CabrilloRoboticsClub/robosub_electrical/README.md

### Electrical stack up for RoboSub 2025 Lasershark

For documention take a look at:
https://github.com/CabrilloRoboticsClub/robosub_electrical/wiki

Desing requirments document:
https://docs.google.com/document/d/1Yq5ZJsRXAqFWiCNv81dD8MaTSv5xLRyw4zoX7664jJk/edit?usp=sharing
