CabrilloRoboticsClub/robosub_electrical/spice/Screenshot 2024-10-26 230412.png

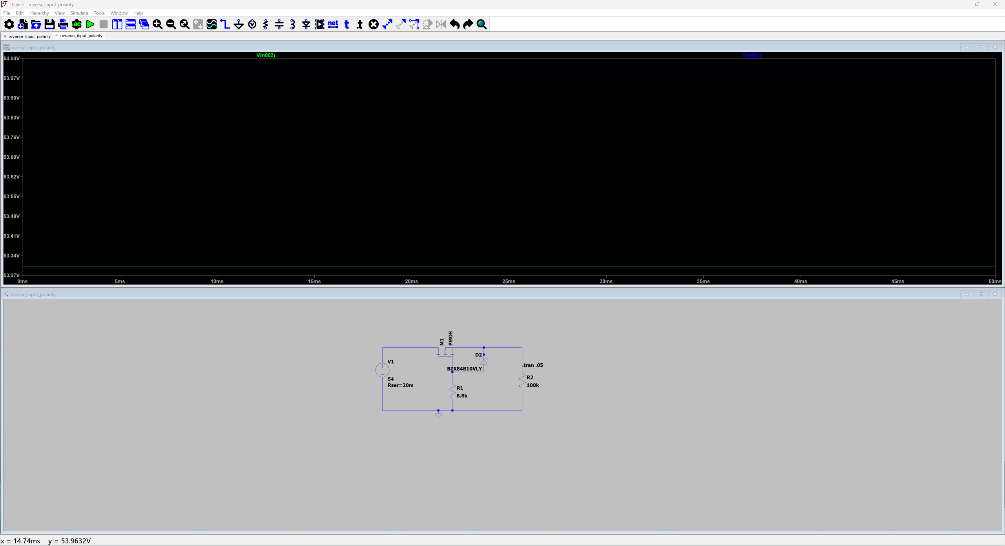
spice/Screenshot 2024-10-26 230412.png
