CabrilloRoboticsClub/robosub_electrical/libary/0ZCG0300FF2B/0ZCG_BEL.step

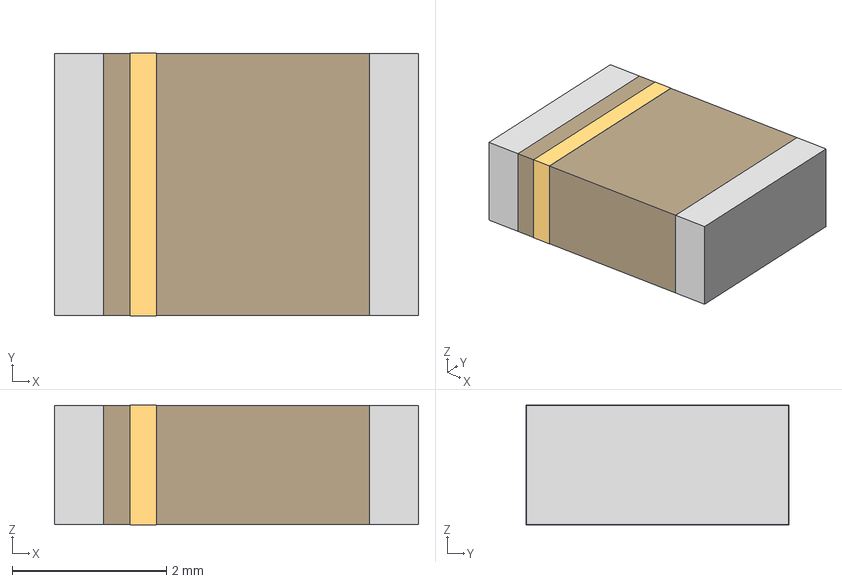
[picture p2: CAD file, 2024-11-19]
libary/0ZCG0300FF2B/0ZCG_BEL.step
4.72 x 3.41 x 1.55 mm
