CabrilloRoboticsClub/robosub_electrical/libary/C2012X5R1V226M125AC/C2012X5R1V226M125AC.step

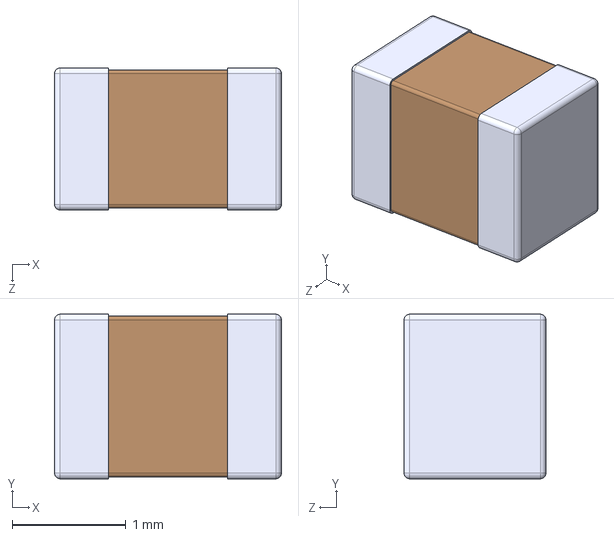
[picture p3: CAD file, 2024-10-15]
libary/C2012X5R1V226M125AC/C2012X5R1V226M125AC.step
2.00 x 1.45 x 1.25 mm
