CabrilloRoboticsClub/robosub_electrical/libary/EEV-TG2A331M/EEVTG2A331M.step

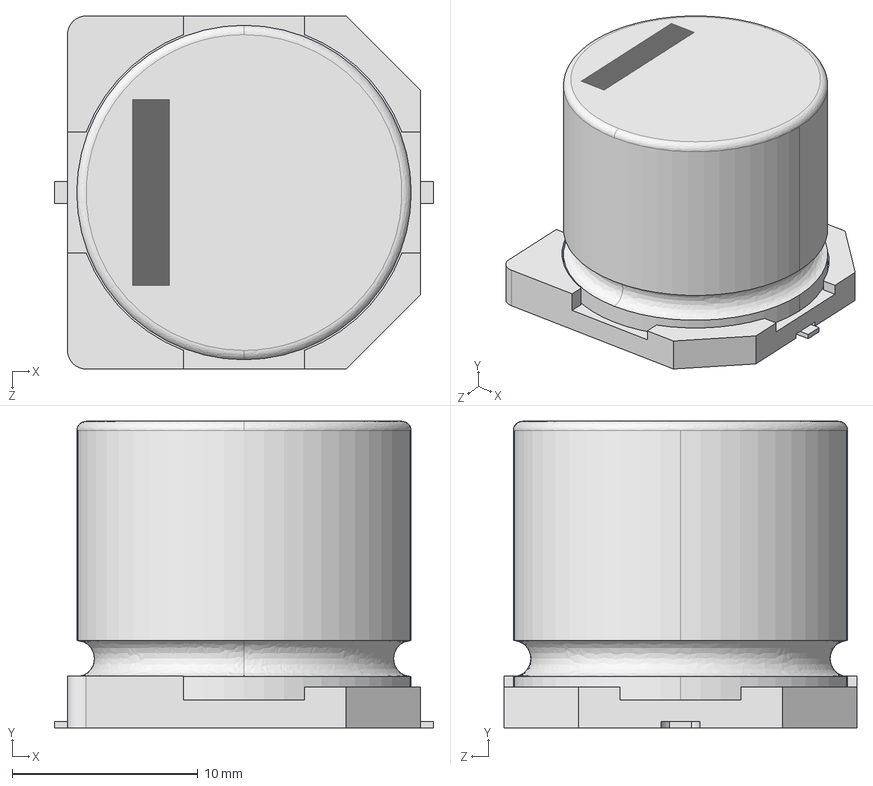
[picture p4: CAD file, 2024-11-05]
libary/EEV-TG2A331M/EEVTG2A331M.step
20.4 x 16.5 x 19.0 mm
