CabrilloRoboticsClub/robosub_electrical/libary/FDMS86163P/TRAN_FDMS86163P_OSI.step

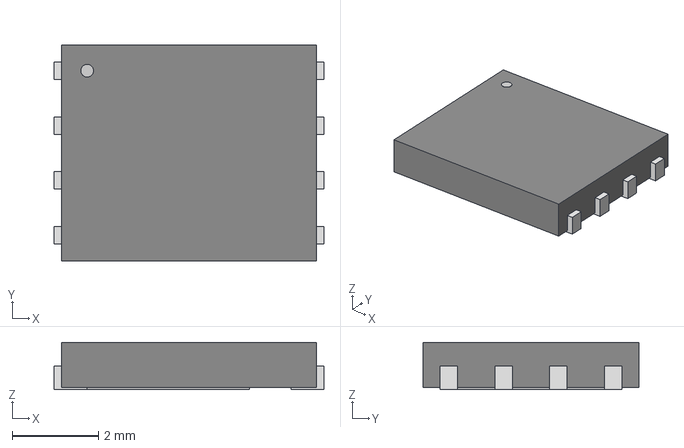
[picture p5: CAD file, 2024-11-19]
libary/FDMS86163P/TRAN_FDMS86163P_OSI.step
6.25 x 5.00 x 1.09 mm
