CabrilloRoboticsClub/robosub_electrical/libary/INA740BIREMR/REM0014B.stp

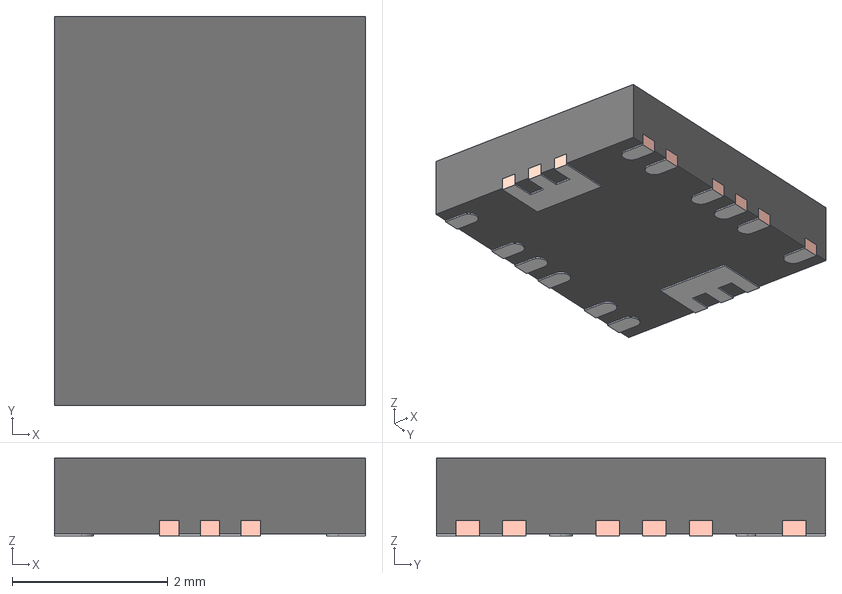
[picture p6: CAD file, 2024-11-05]
libary/INA740BIREMR/REM0014B.stp
4.00 x 5.00 x 1.00 mm
FRAME
PIN1_AREA
