CabrilloRoboticsClub/robosub_electrical/libary/IPS1-120-01-L-D/IPS1-120-01-L-D.step

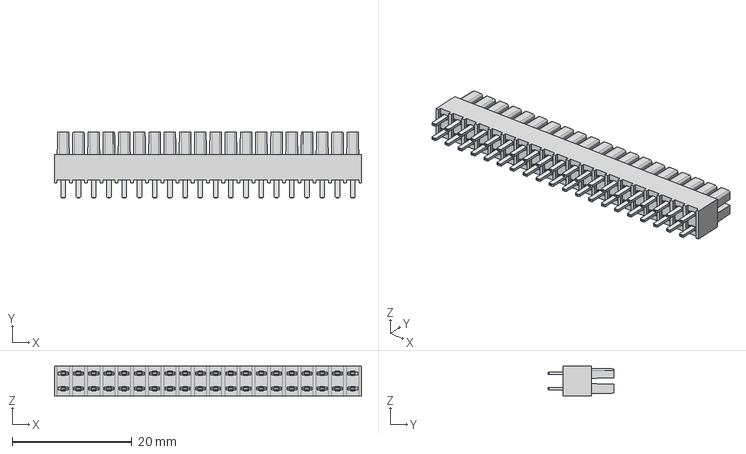
[picture p7: CAD file, 2024-09-06]
libary/IPS1-120-01-L-D/IPS1-120-01-L-D.step
51.2 x 11.0 x 4.95 mm
IPS1-120-01-L-Dt
IPS1-120-01-L-D_pin
