CabrilloRoboticsClub/robosub_electrical/libary/KDV12FR330ET/RES_KDV12_OHM.step

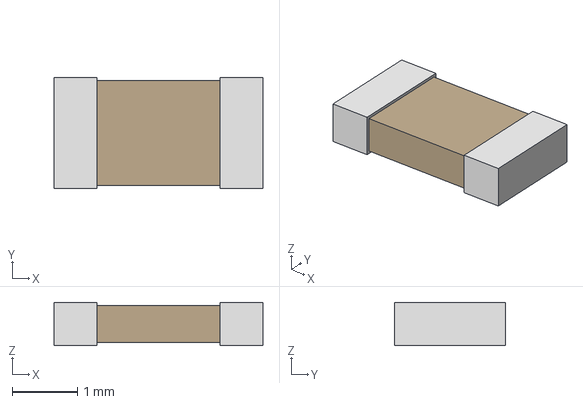
[picture p8: CAD file, 2024-10-29]
libary/KDV12FR330ET/RES_KDV12_OHM.step
3.20 x 1.70 x 0.66 mm
