CabrilloRoboticsClub/robosub_electrical/libary/OSTTE020104/OSTTE020104.step

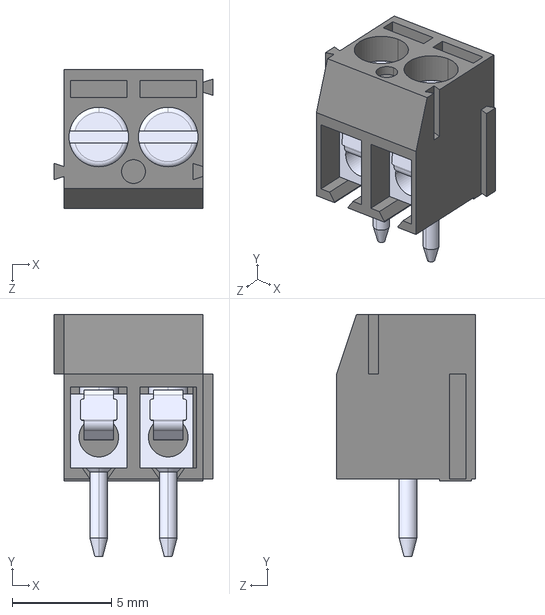
[picture p9: CAD file, 2024-12-24]
libary/OSTTE020104/OSTTE020104.step
8.00 x 12.2 x 7.00 mm
