CabrilloRoboticsClub/robosub_electrical/libary/PKJ7213WPI/FPM-3DSTEP-PKJ7200W-simplified-typ.stp

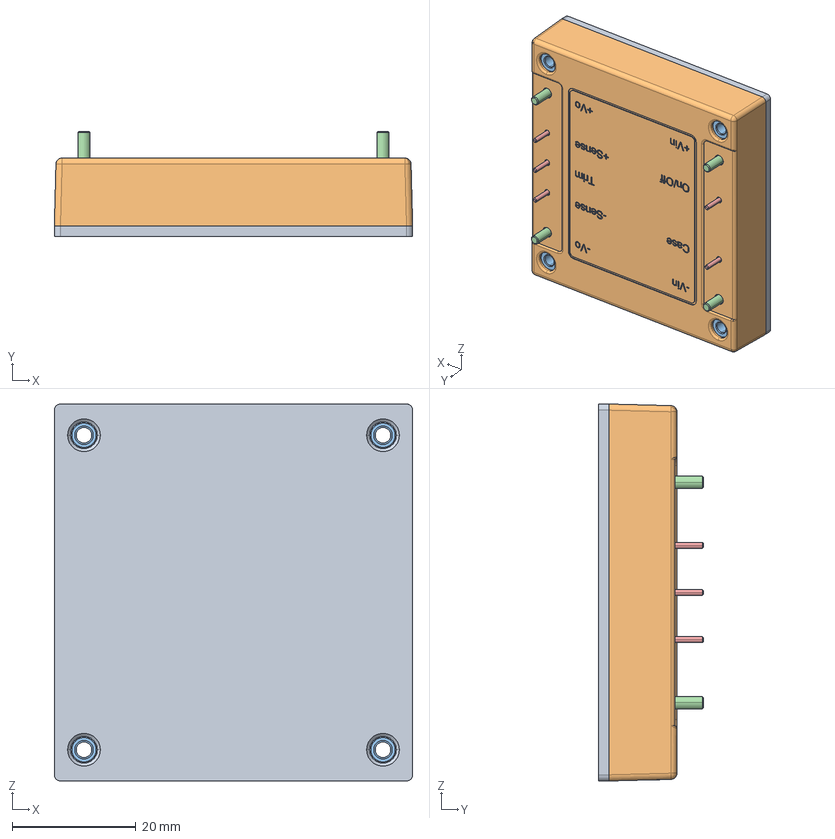
[picture p10: CAD file, 2024-10-02]
libary/PKJ7213WPI/FPM-3DSTEP-PKJ7200W-simplified-typ.stp
57.9 x 17.0 x 60.9 mm
MAIN_PCB
54GMFH200EA2_V2
SCREW_BOSS x 4
03G12015R201 x 4
03G1069R0001 x 5
UMRH200ECP24ERG_LABEL
