CabrilloRoboticsClub/robosub_electrical/libary/PKU3511SPI/PKU3500S_FPM.step

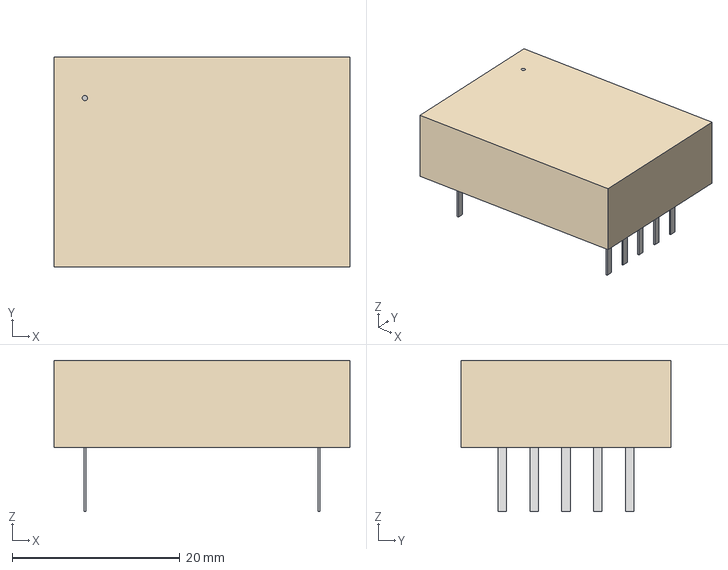
[picture p11: CAD file, 2024-09-27]
libary/PKU3511SPI/PKU3500S_FPM.step
35.3 x 25.0 x 18.0 mm
