CabrilloRoboticsClub/robosub_electrical/libary/SI7615ADN-T1-GE3/SI7615ADN-T1-GE3.STEP

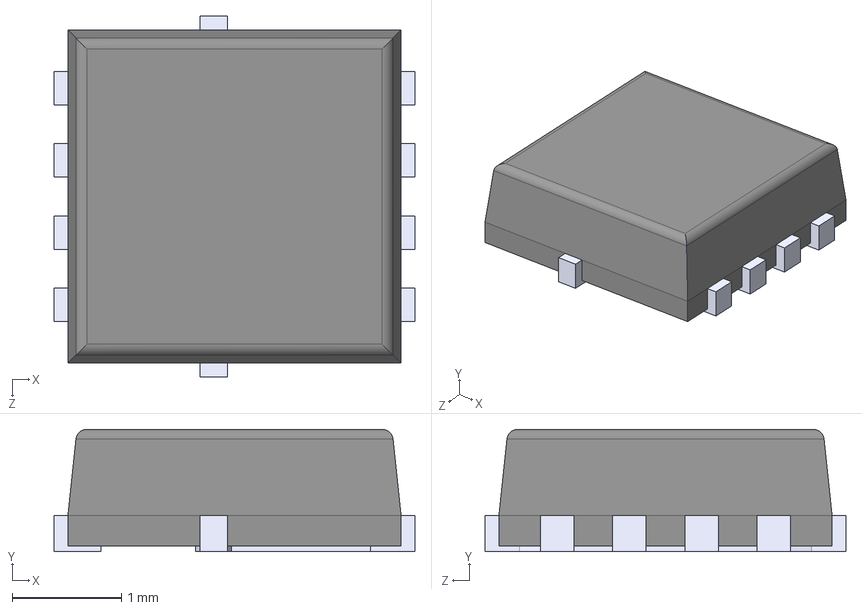
[picture p12: CAD file, 2024-11-15]
libary/SI7615ADN-T1-GE3/SI7615ADN-T1-GE3.STEP
3.30 x 1.12 x 3.30 mm
