CabrilloRoboticsClub/robosub_electrical/libary/SSD1306-128x64/DM-OLED096-636.step

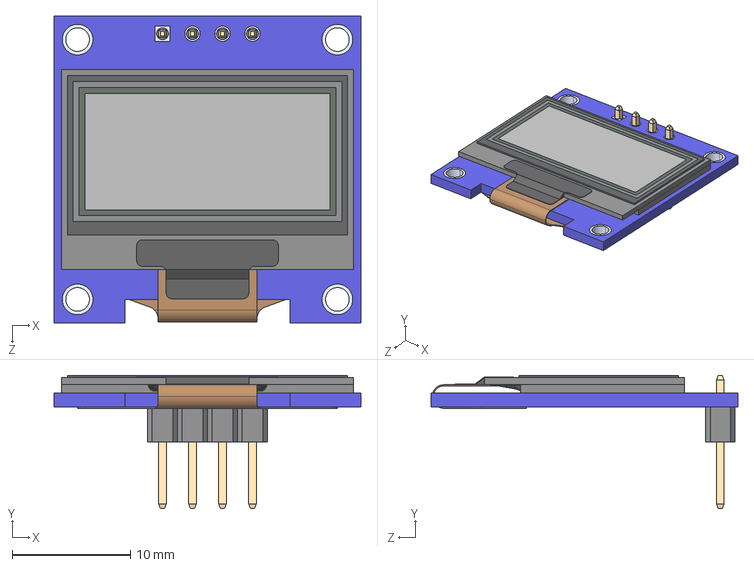
[picture p13: CAD file, 2024-12-21]
libary/SSD1306-128x64/DM-OLED096-636.step
26.0 x 11.3 x 26.0 mm
DM-OLED096-636_Module
DM-OLED096-636_Panel
