CabrilloRoboticsClub/robosub_electrical/libary/XT30U-F/XT30U-F_IW.STEP

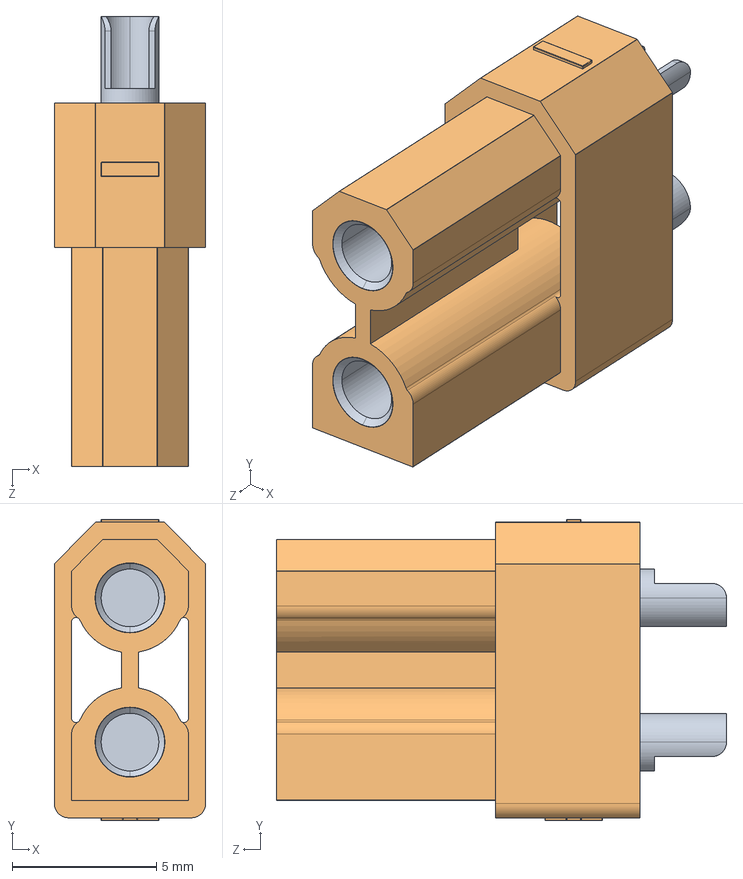
[picture p14: CAD file, 2024-12-24]
libary/XT30U-F/XT30U-F_IW.STEP
5.25 x 10.4 x 15.6 mm
