CabrilloRoboticsClub/robosub_electrical/spice/reverse_input_polarity.asc

D2: zener; BZX84B10VLY
M1: pmos
R1: res; 8.8k
R2: res; 100k
V1: voltage; 54; Rser=20m
Named nets: 0
.tran .05
