CabrilloRoboticsClub/robosub_electrical/Backplane_Board/Backplane_Board.kicad_pcb

## KiCad design Backplane_Board/Backplane_Board.kicad_pcb (2025-02-01)

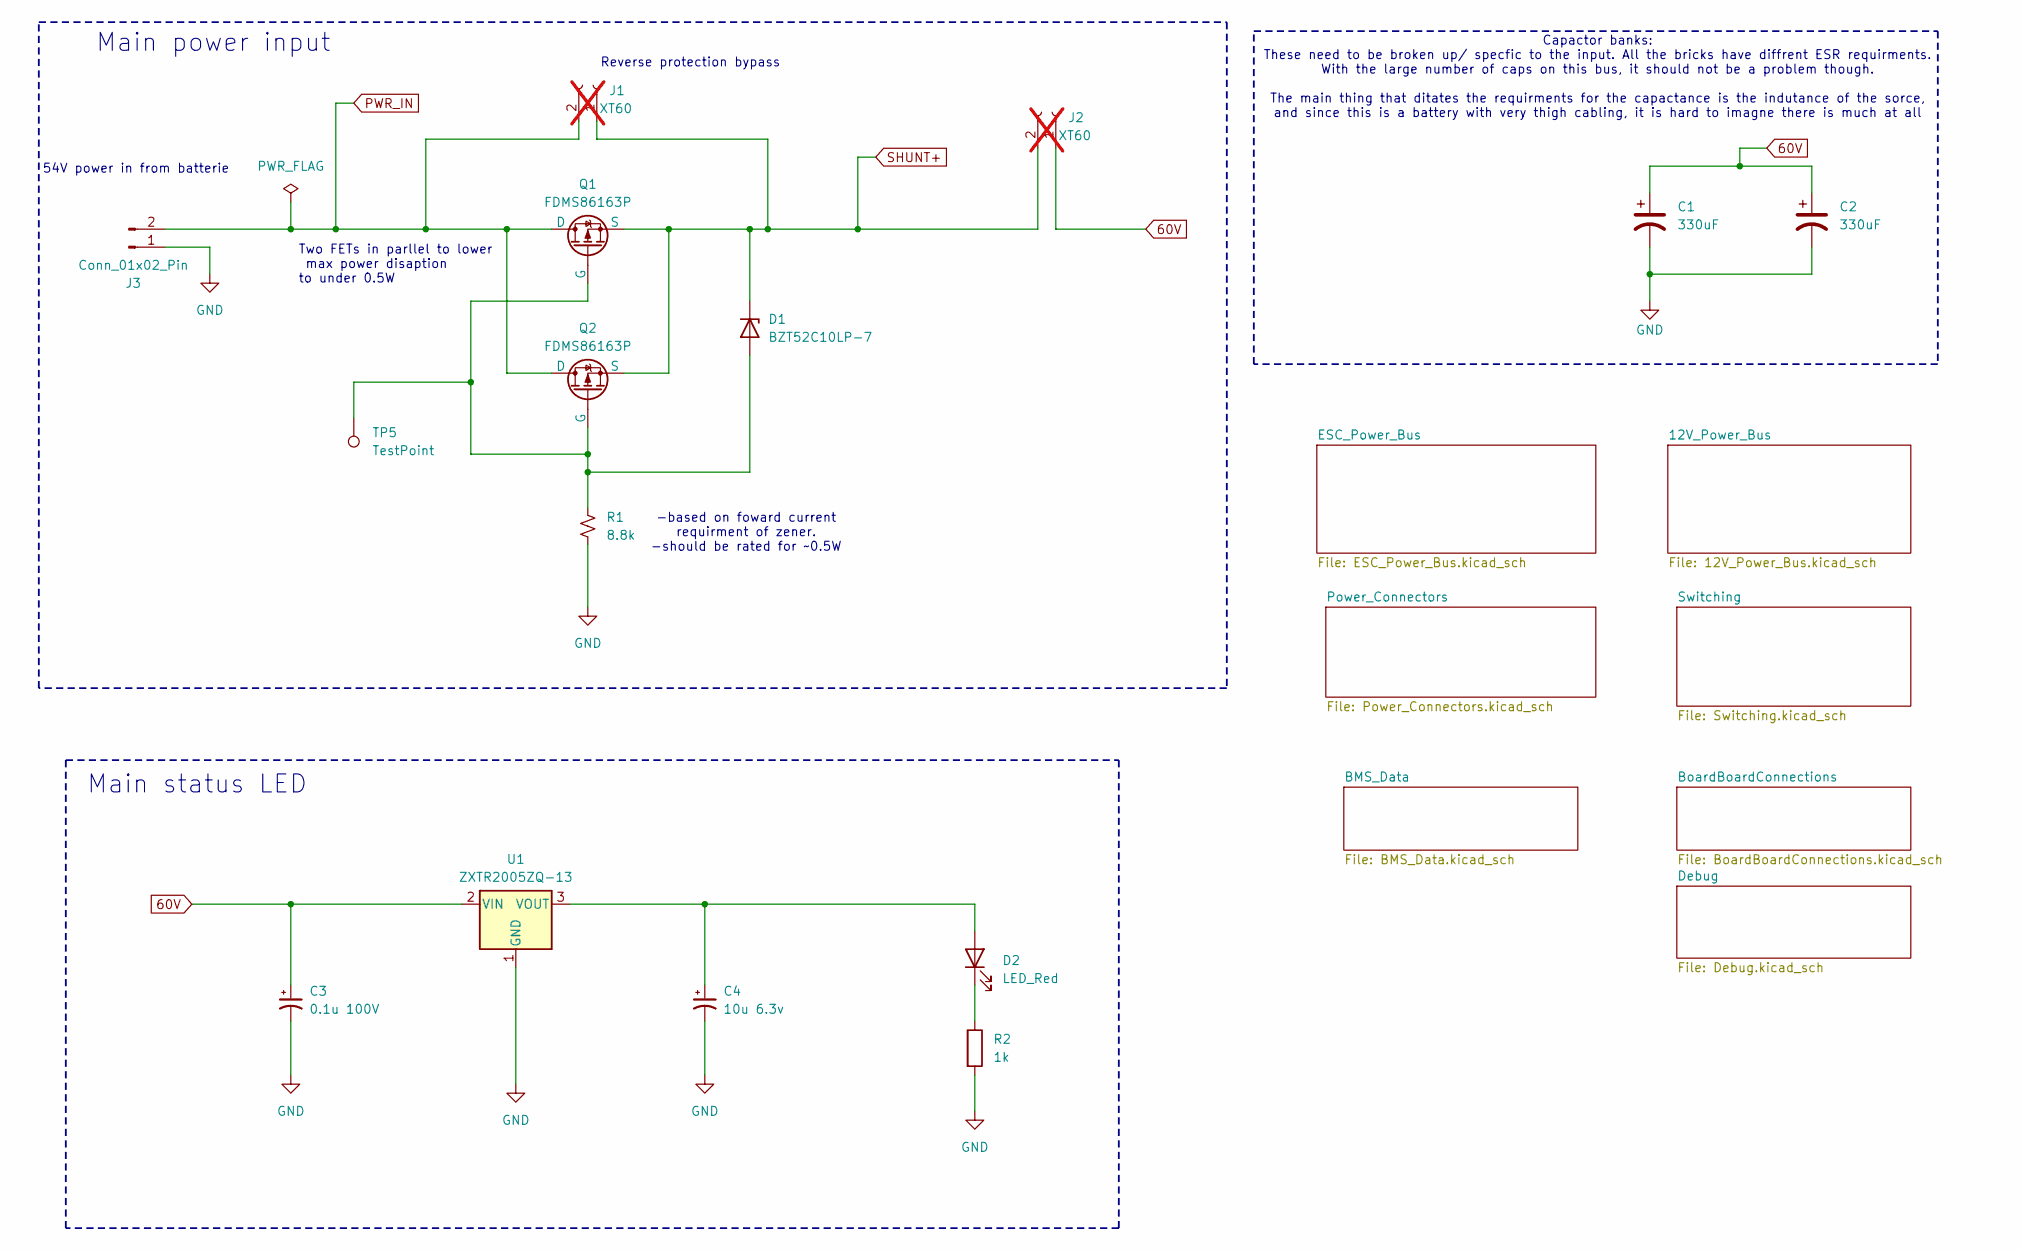
[picture p23: schematic Backplane_Board.kicad_sch]

Parts:
C1, C2: 330uF; CAP_EEVTG2A331M
C3: 0.1u 100V; C_1206_3216Metric_Pad1.33x1.80mm_HandSolder
C4: 10u 6.3v; C_1206_3216Metric_Pad1.33x1.80mm_HandSolder
D1: BZT52C10LP-7; D_SOD-882
D2: LED_Red; LED_0603_1608Metric
J1, J2: XT60; SolderWire-0.127sqmm_1x02_P3.7mm_D0.48mm_OD1mm; not fitted
J3: Conn_01x02_Pin; AMASS_XT60-M_1x02_P7.20mm_Vertical
Q1, Q2: FDMS86163P
R1: 8.8k; R_1206_3216Metric_Pad1.30x1.75mm_HandSolder
R2: 1k; R_0805_2012Metric_Pad1.20x1.40mm_HandSolder
TP5: TestPoint; TestPoint_Pad_2.5x2.5mm
U1: ZXTR2005ZQ-13; SOT-89-3_Handsoldering

Connections:
60V: C1.1, C2.1, C3.1, J2.1, U1.2 (VIN); also elsewhere on the board
GND: C1.2, C2.2, C3.2, C4.2, J3.1, R1.2, R2.2, U1.1 (GND); also elsewhere on the board
unnamed: D1.2 (A), Q1.2 (G), Q2.2 (G), R1.1, TP5.1
unnamed: C4.1, D2.2 (A), U1.3 (VOUT)
unnamed: D2.1 (K), R2.1
PWR_IN: J1.2, J3.2, Q1.1 (D), Q2.1 (D)
SHUNT+: D1.1 (K), J1.1, J2.2, Q1.3 (S), Q2.3 (S); also elsewhere on the board

Notes on the sheet:
Capactor banks: These need to be broken up/ specfic to the input. All the bricks have diffrent ESR requirments. With the large number of caps on this bus, it should not be a problem though. The main thing that ditates the requirments for the capactance is the indutance of the sorce, and since this 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
Main status LED
54V power in from batterie
Main power input
Reverse protection bypass
Two FETs in parllel to lower max power disaption to under 0.5W
-based on foward current requirment of zener. -should be rated for ~0.5W

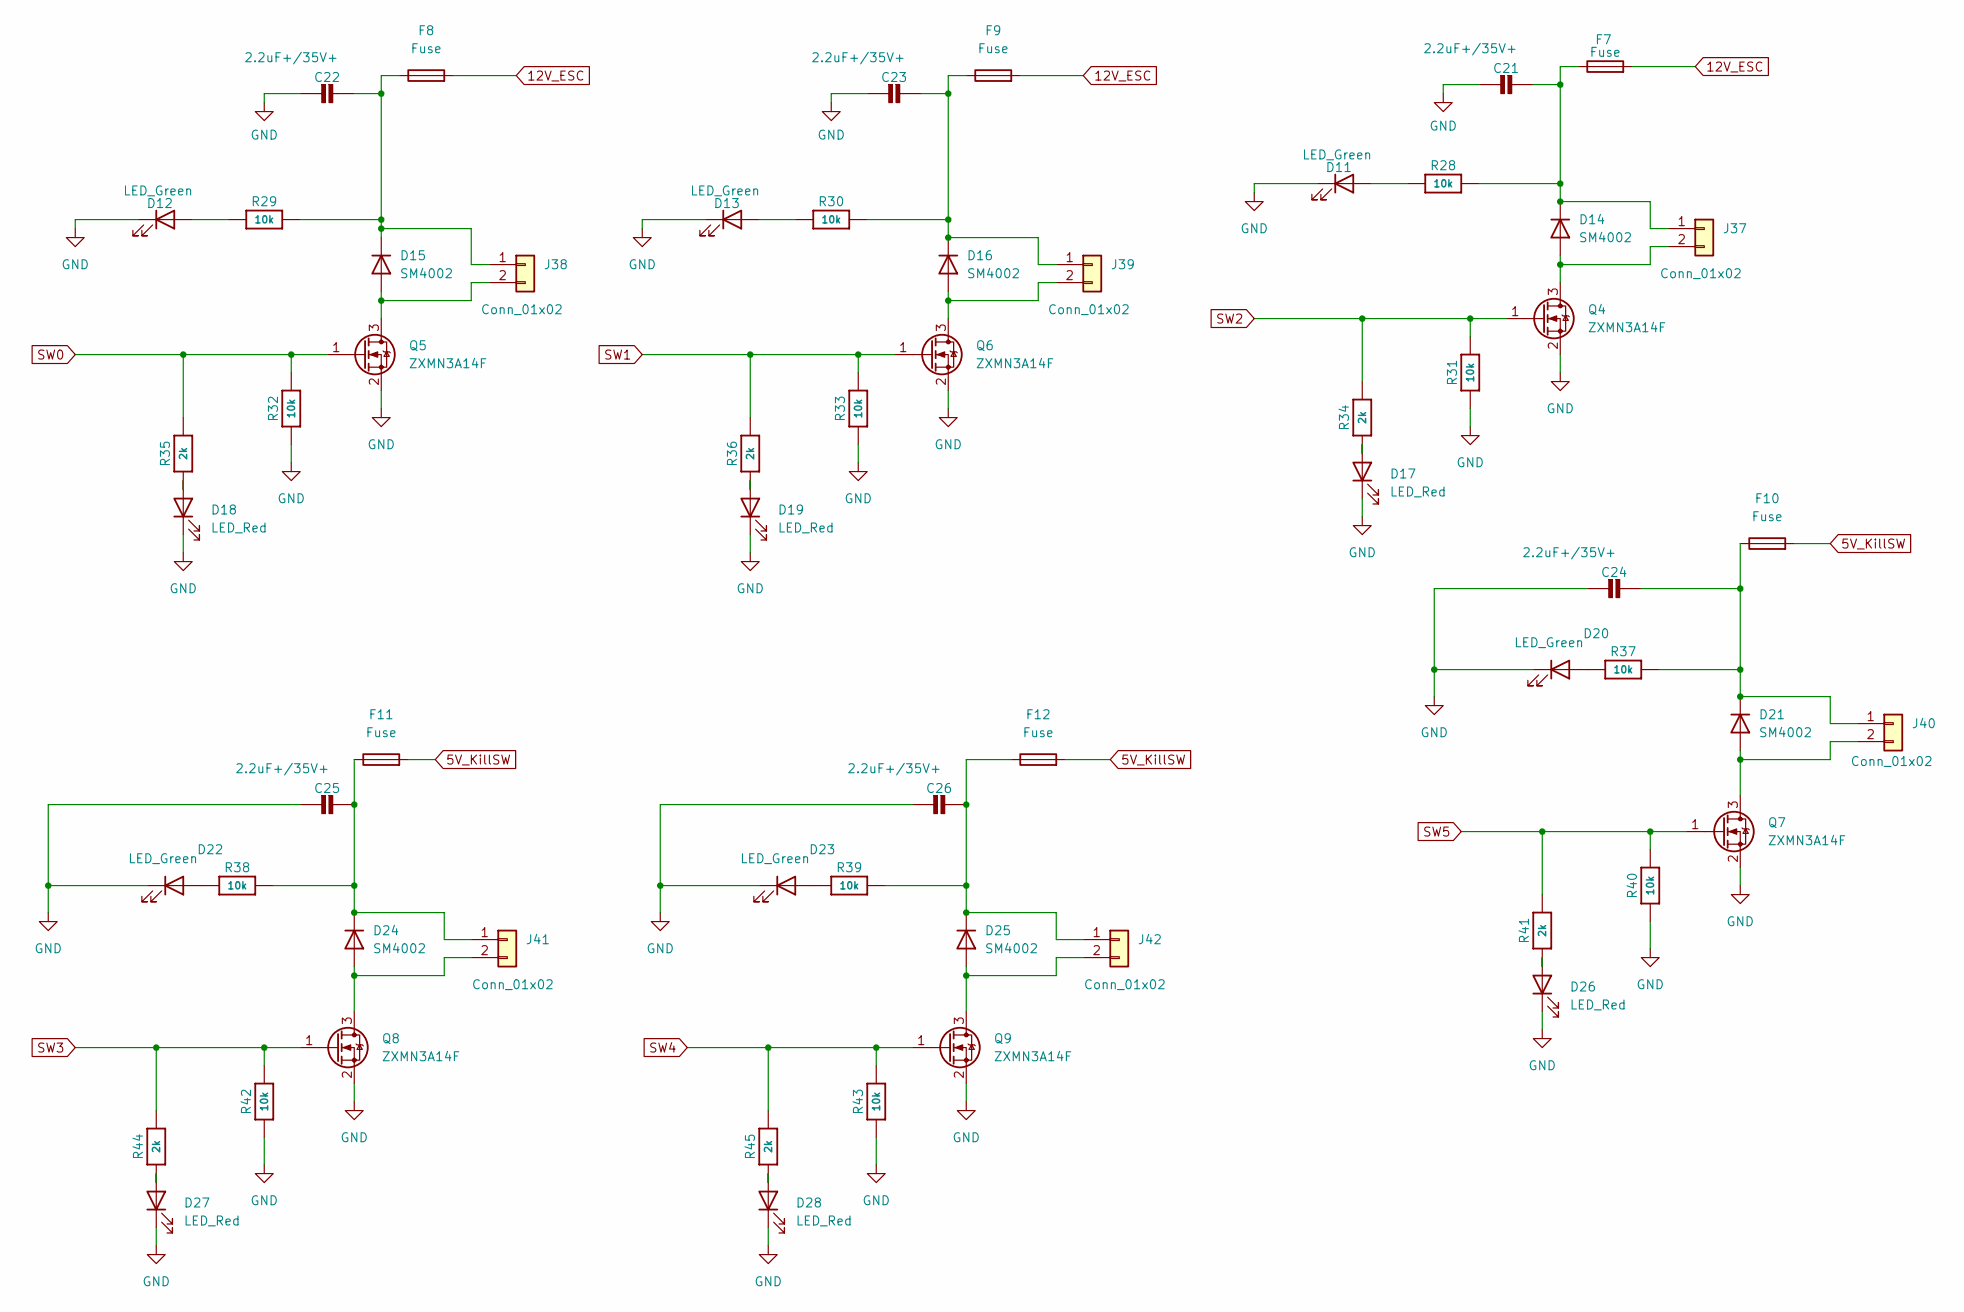
[picture p24: schematic Switching.kicad_sch]

Parts:
C21, C22, C23, C24, C25, C26: 2.2uF+/35V+; C_0805_2012Metric
D11, D12, D13, D20, D22, D23: LED_Green; LED_0603_1608Metric
D14, D15, D16, D21, D24, D25: SM4002; D_SOD-123F
D17, D18, D19, D26, D27, D28: LED_Red; LED_0603_1608Metric
F7, F8, F9, F10, F11, F12: Fuse; Fuse_0805_2012Metric
J37, J38, J39, J40, J41, J42: Conn_01x02; Molex_Micro-Latch_53253-0270_1x02_P2.00mm_Vertical
Q4, Q5, Q6, Q7, Q8, Q9: ZXMN3A14F; SOT-23
R28, R29, R30, R31, R32, R33, R37, R38, R39, R40, R42, R43: 10k; R_0805_2012Metric
R34, R35, R36, R41, R44, R45: 2k; R_0805_2012Metric

Connections:
5V_KillSW: F10.2, F11.2, F12.2; also elsewhere on the board
12V_ESC: F7.2, F8.2, F9.2; also elsewhere on the board
GND: C21.2, C22.2, C23.2, C24.2, C25.2, C26.2, D11.1 (K), D12.1 (K), D13.1 (K), D17.1 (K), D18.1 (K), D19.1 (K), D20.1 (K), D22.1 (K), D23.1 (K), D26.1 (K), D27.1 (K), D28.1 (K), Q4.2 (S), Q5.2 (S), Q6.2 (S), Q7.2 (S), Q8.2 (S), Q9.2 (S), R31.1, R32.1, R33.1, R40.1, R42.1, R43.1; also elsewhere on the board
unnamed: D11.2 (A), R28.1
unnamed: D12.2 (A), R29.1
unnamed: D13.2 (A), R30.1
unnamed: D14.2 (A), J37.2, Q4.3 (D)
unnamed: C21.1, D14.1 (K), F7.1, J37.1, R28.2
unnamed: D15.2 (A), J38.2, Q5.3 (D)
unnamed: C22.1, D15.1 (K), F8.1, J38.1, R29.2
unnamed: D16.2 (A), J39.2, Q6.3 (D)
unnamed: C23.1, D16.1 (K), F9.1, J39.1, R30.2
unnamed: D17.2 (A), R34.1
unnamed: D18.2 (A), R35.1
unnamed: D19.2 (A), R36.1
unnamed: D20.2 (A), R37.1
unnamed: D21.2 (A), J40.2, Q7.3 (D)
unnamed: C24.1, D21.1 (K), F10.1, J40.1, R37.2
unnamed: D22.2 (A), R38.1
unnamed: D23.2 (A), R39.1
unnamed: D24.2 (A), J41.2, Q8.3 (D)
unnamed: C25.1, D24.1 (K), F11.1, J41.1, R38.2
unnamed: D25.2 (A), J42.2, Q9.3 (D)
unnamed: C26.1, D25.1 (K), F12.1, J42.1, R39.2
unnamed: D26.2 (A), R41.1
unnamed: D27.2 (A), R44.1
unnamed: D28.2 (A), R45.1
SW0: Q5.1 (G), R32.2, R35.2; also elsewhere on the board
SW1: Q6.1 (G), R33.2, R36.2; also elsewhere on the board
SW2: Q4.1 (G), R31.2, R34.2; also elsewhere on the board
SW3: Q8.1 (G), R42.2, R44.2; also elsewhere on the board
SW4: Q9.1 (G), R43.2, R45.2; also elsewhere on the board
SW5: Q7.1 (G), R40.2, R41.2; also elsewhere on the board

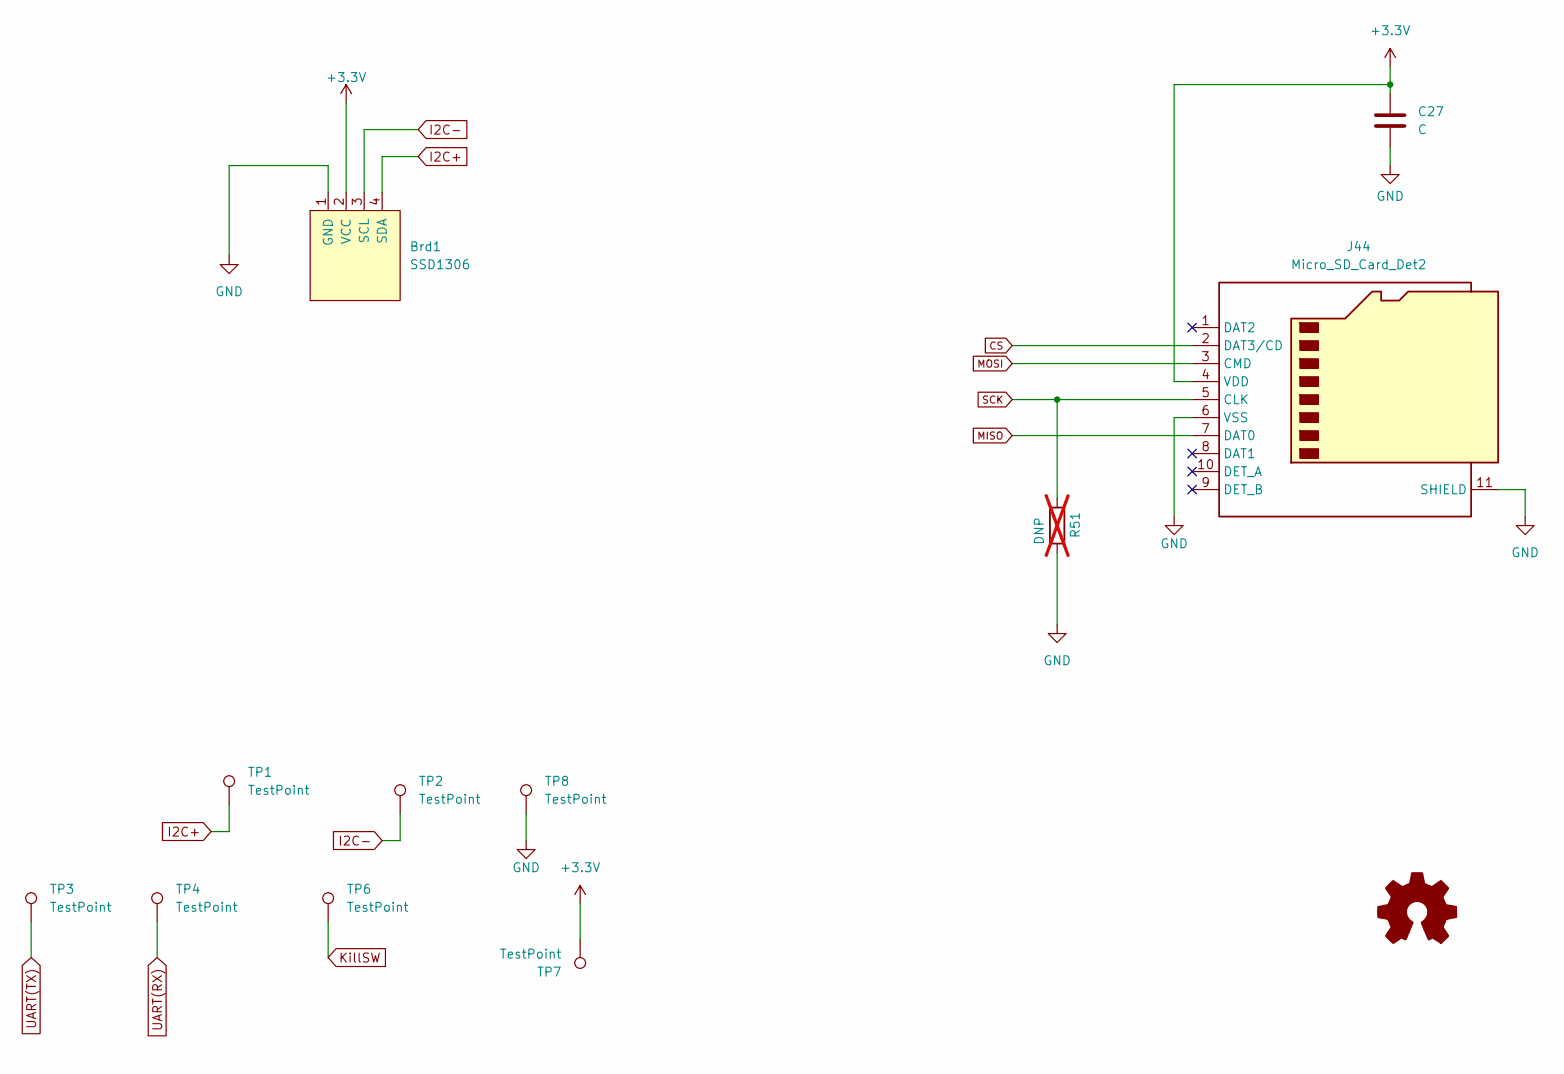
[picture p25: schematic Debug.kicad_sch]

Parts:
Brd1: SSD1306; MODULE_DM-OLED096-636
C27: C; C_1206_3216Metric_Pad1.33x1.80mm_HandSolder
J44: Micro_SD_Card_Det2; microSD_HC_Hirose_DM3D-SF
R51: DNP; R_0805_2012Metric_Pad1.20x1.40mm_HandSolder; not fitted
TP1, TP2, TP8: TestPoint; TestPoint_Loop_D1.80mm_Drill1.0mm_Beaded
TP3, TP4, TP6, TP7: TestPoint; TestPoint_Pad_2.5x2.5mm

Connections:
+3.3V: Brd1.2 (VCC), C27.1, J44.4 (VDD), TP7.1; also elsewhere on the board
CS: J44.2 (DAT3/CD); also elsewhere on the board
GND: Brd1.1 (GND), C27.2, J44.6 (VSS), J44.11 (SHIELD), R51.1, TP8.1; also elsewhere on the board
I2C+: Brd1.4 (SDA), TP1.1; also elsewhere on the board
I2C-: Brd1.3 (SCL), TP2.1; also elsewhere on the board
KillSW: TP6.1; also elsewhere on the board
MISO: J44.7 (DAT0); also elsewhere on the board
MOSI: J44.3 (CMD); also elsewhere on the board
SCK: J44.5 (CLK), R51.2; also elsewhere on the board
UART(RX): TP4.1; also elsewhere on the board
UART(TX): TP3.1; also elsewhere on the board

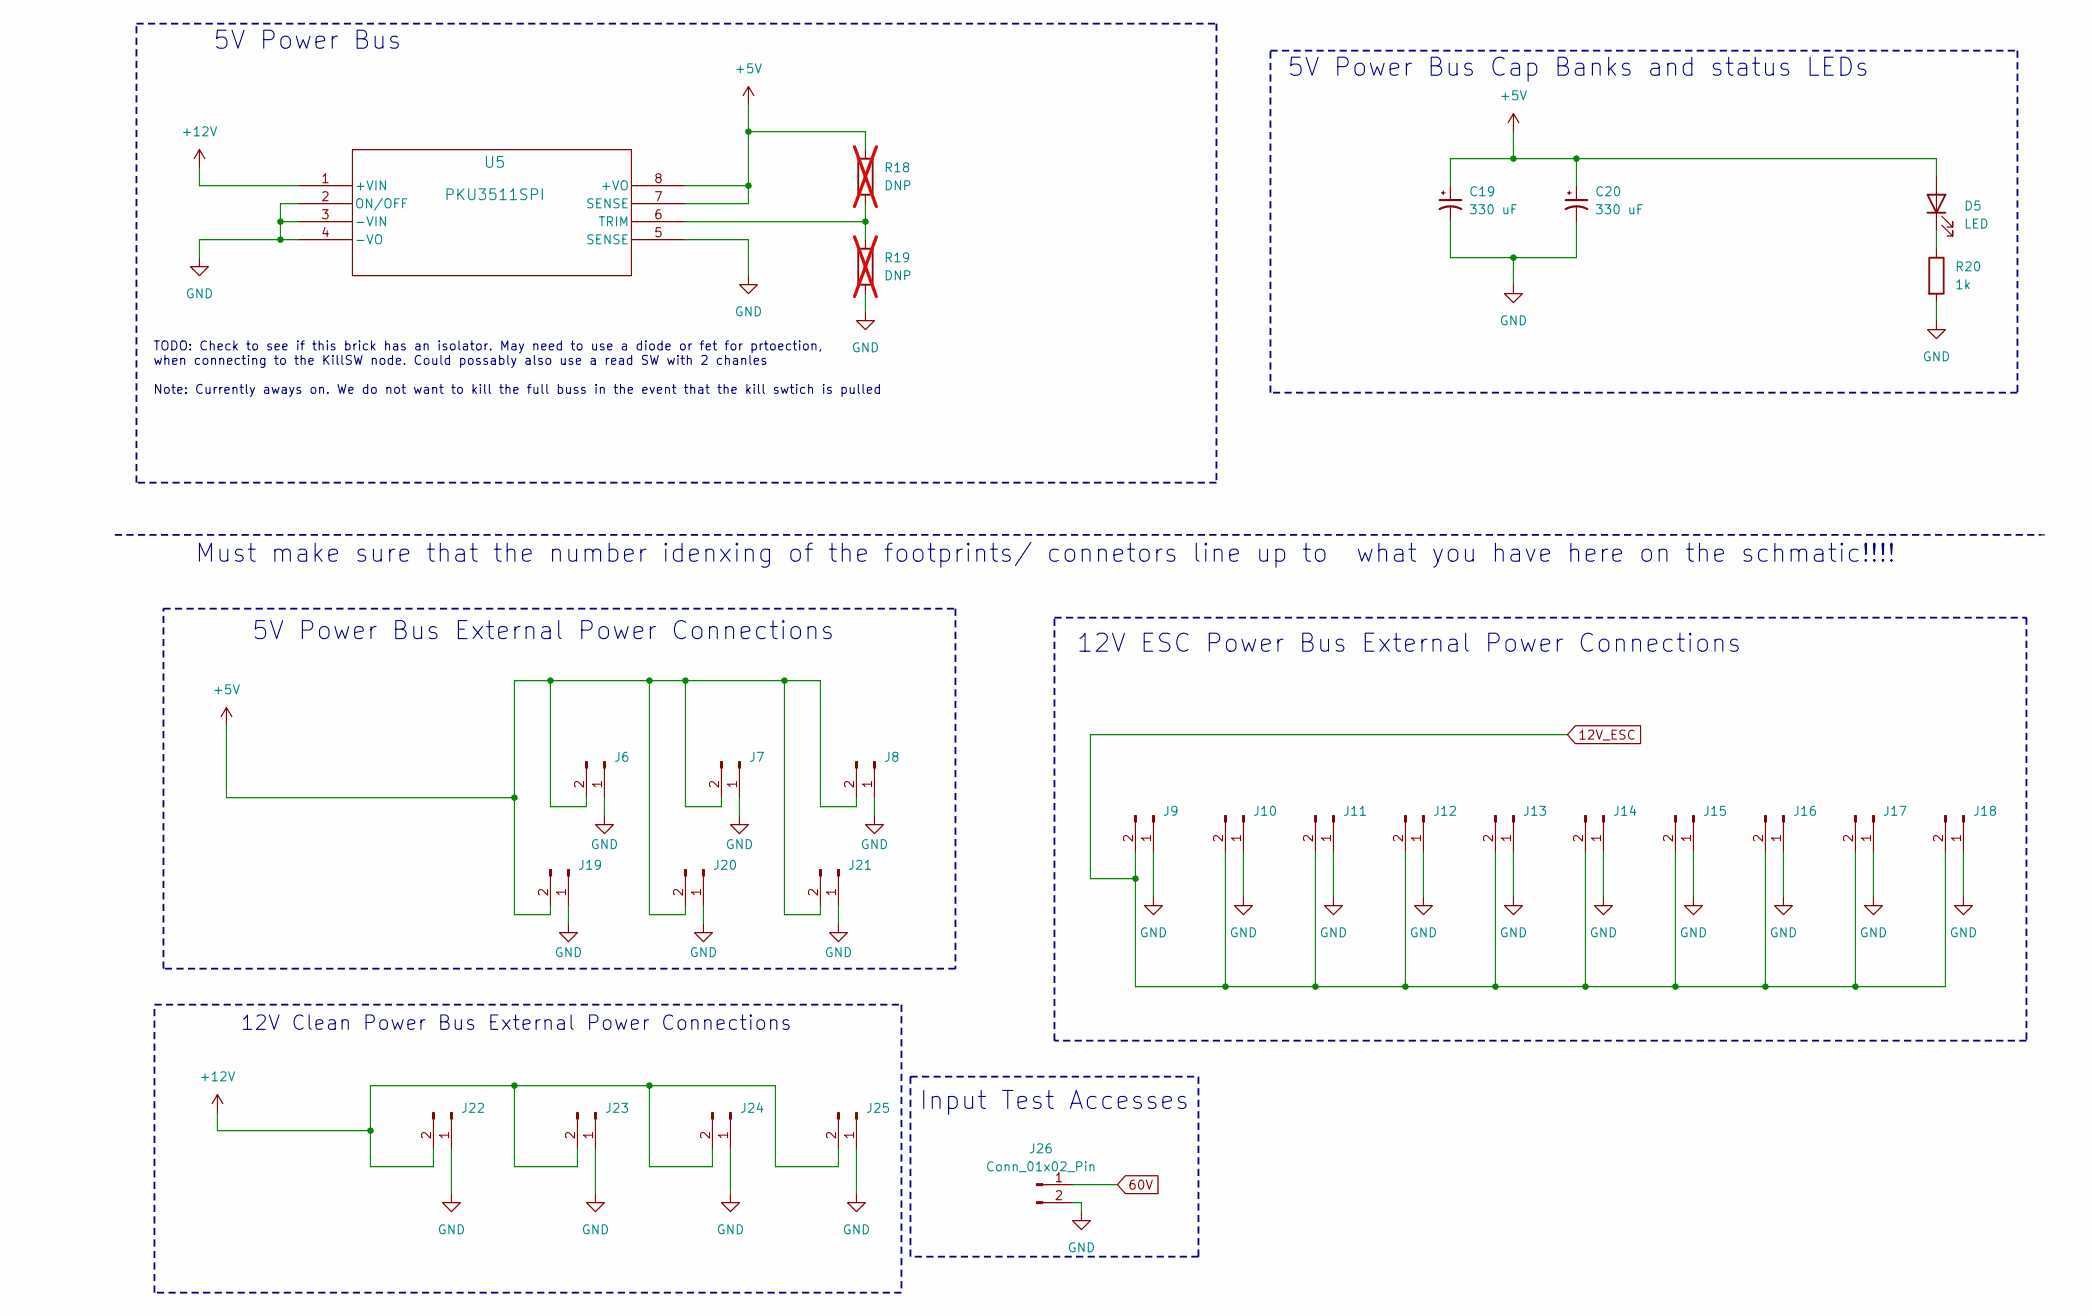
[picture p26: schematic Power_Connectors.kicad_sch, Backplane_Board]

Parts:
C19, C20: 330 uF; CP_Elec_6.3x7.7
D5: LED; LED_0603_1608Metric
J6, J7, J8, J19, J20, J21: Conn_01x02_Pin; TerminalBlock_4Ucon_1x02_P3.50mm_Horizontal_updated
J9, J10, J11, J12, J13, J14, J15, J16, J17, J18, J22, J23, J24, J25: Conn_01x02_Pin; AMASS_XT30U-M_1x02_P5.0mm_Vertical_IW_3d
J26: Conn_01x02_Pin; TestPoint_2Pads_Pitch2.54mm_Drill0.8mm
R18, R19: DNP; L_1206_3216Metric; not fitted
R20: 1k; R_0805_2012Metric_Pad1.20x1.40mm_HandSolder
U5: PKU3511SPI; PKU 3500S_FPM

Connections:
12V_ESC: J9.2, J10.2, J11.2, J12.2, J13.2, J14.2, J15.2, J16.2, J17.2, J18.2; also elsewhere on the board
60V: J26.1; also elsewhere on the board
+5V: C19.1, C20.1, D5.2 (A), J6.2, J7.2, J8.2, J19.2, J20.2, J21.2, R18.1, U5.7 (SENSE), U5.8 (+VO); also elsewhere on the board
+12V: J22.2, J23.2, J24.2, J25.2, U5.1 (+VIN); also elsewhere on the board
GND: C19.2, C20.2, J6.1, J7.1, J8.1, J9.1, J10.1, J11.1, J12.1, J13.1, J14.1, J15.1, J16.1, J17.1, J18.1, J19.1, J20.1, J21.1, J22.1, J23.1, J24.1, J25.1, J26.2, R19.2, R20.2, U5.2 (ON/OFF), U5.3 (-VIN), U5.4 (-VO), U5.5 (SENSE); also elsewhere on the board
unnamed: D5.1 (K), R20.1
unnamed: R18.2, R19.1, U5.6 (TRIM)

Notes on the sheet:
12V Clean Power Bus External Power Connections
Must make sure that the number idenxing of the footprints/ connetors line up to what you have here on the schmatic!!!!
5V Power Bus
5V Power Bus Cap Banks and status LEDs
5V Power Bus External Power Connections
12V ESC Power Bus External Power Connections
TODO: Check to see if this brick has an isolator. May need to use a diode or fet for prtoection, when connecting to the KillSW node. Could possably also use a read SW with 2 chanles Note: Currently aways on. We do not want to kill the full buss in the event that the kill swtich is pulled
Input Test Accesses

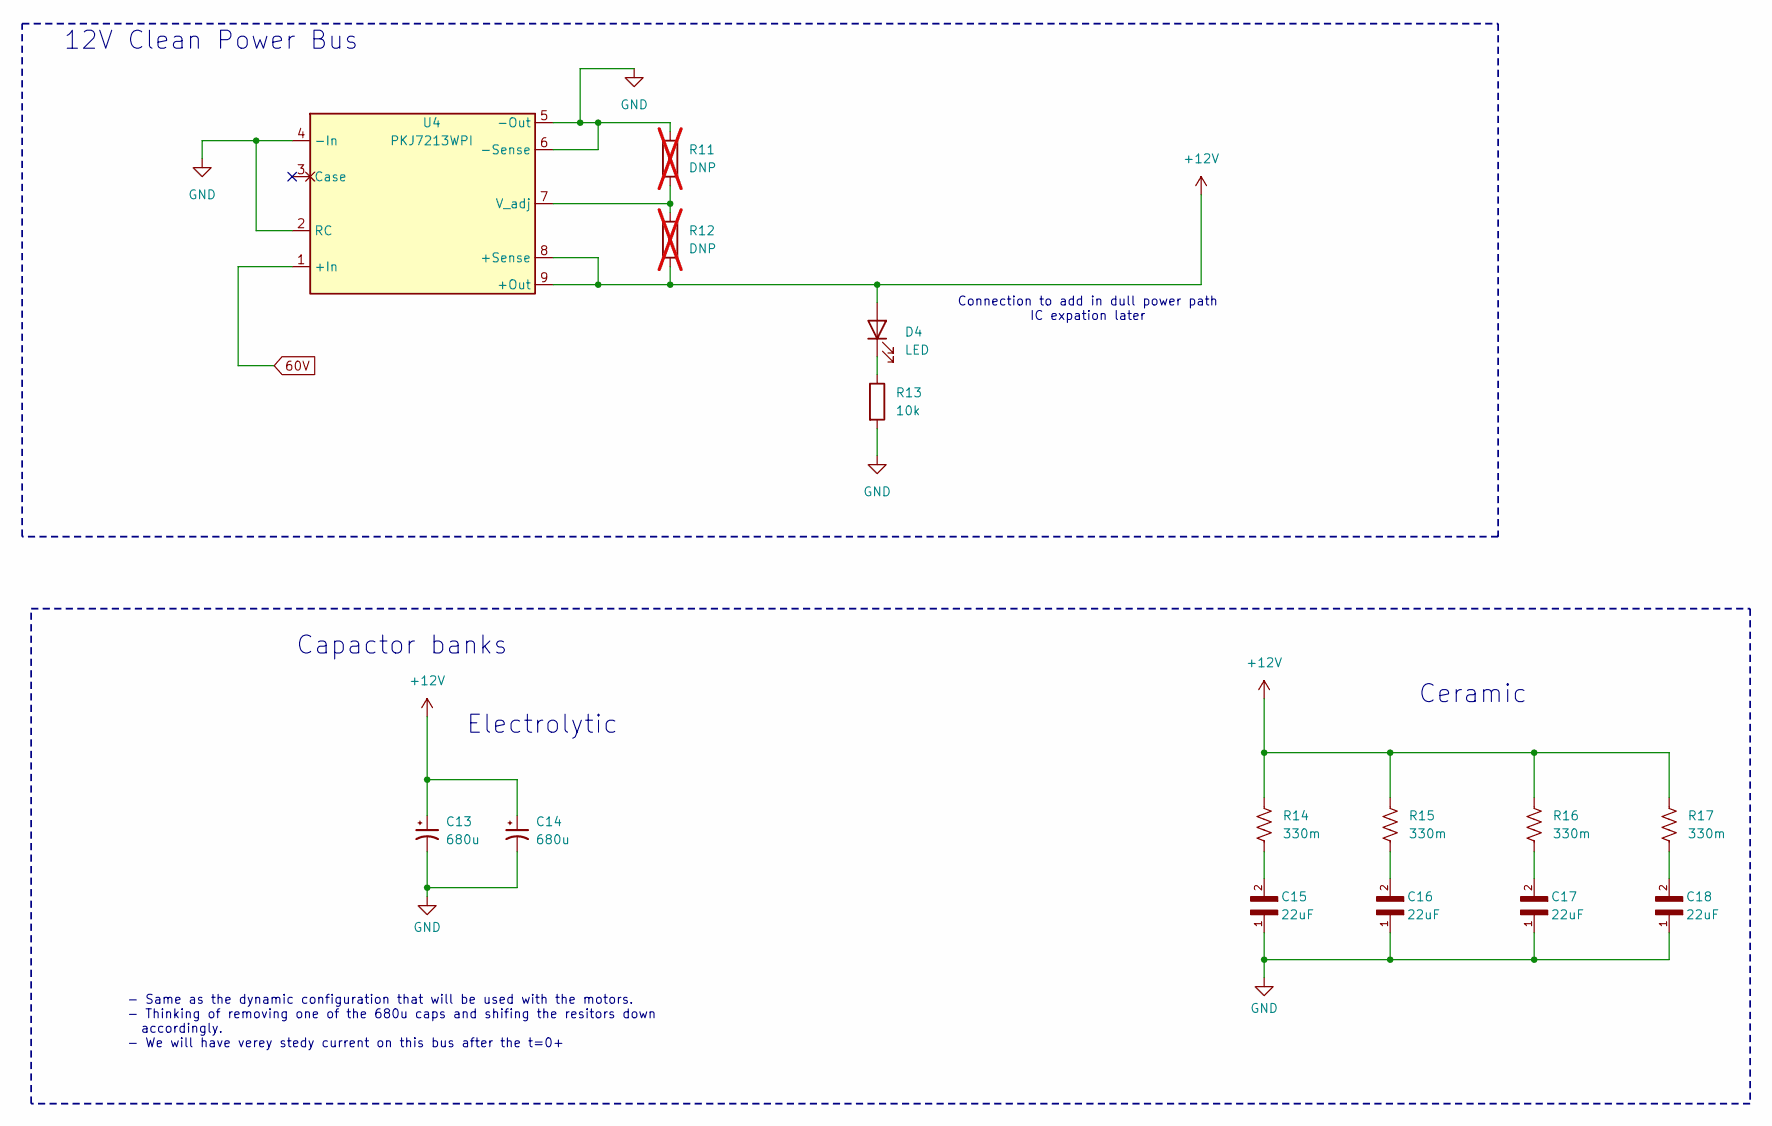
[picture p27: schematic 12V_Power_Bus.kicad_sch, 5V and 12V Power Bus]

Parts:
C13, C14: 680u; CP_Radial_D13.0mm_P5.00mm
C15, C16, C17, C18: 22uF; C_1206_3216Metric_Pad1.33x1.80mm_HandSolder
D4: LED; LED_0603_1608Metric
R11, R12: DNP; L_1206_3216Metric; not fitted
R13: 10k; R_0805_2012Metric_Pad1.20x1.40mm_HandSolder
R14, R15, R16, R17: 330m; RES_KDV12_OHM-L
U4: PKJ7213WPI

Connections:
60V: U4.1 (+In); also elsewhere on the board
+12V: C13.1, C14.1, D4.2 (A), R12.2, R14.1, R15.1, R16.1, R17.1, U4.8 (+Sense), U4.9 (+Out); also elsewhere on the board
GND: C13.2, C14.2, C15.1, C16.1, C17.1, C18.1, R11.1, R13.2, U4.2 (RC), U4.4 (-In), U4.5 (-Out), U4.6 (-Sense); also elsewhere on the board
unnamed: C15.2, R14.2
unnamed: C16.2, R15.2
unnamed: C17.2, R16.2
unnamed: C18.2, R17.2
unnamed: D4.1 (K), R13.1
unnamed: R11.2, R12.1, U4.7 (V_adj)

Notes on the sheet:
Ceramic
Electrolytic
Connection to add in dull power path IC expation later
12V Clean Power Bus
- Same as the dynamic configuration that will be used with the motors. - Thinking of removing one of the 680u caps and shifing the resitors down accordingly. - We will have verey stedy current on this bus after the t=0+
Capactor banks

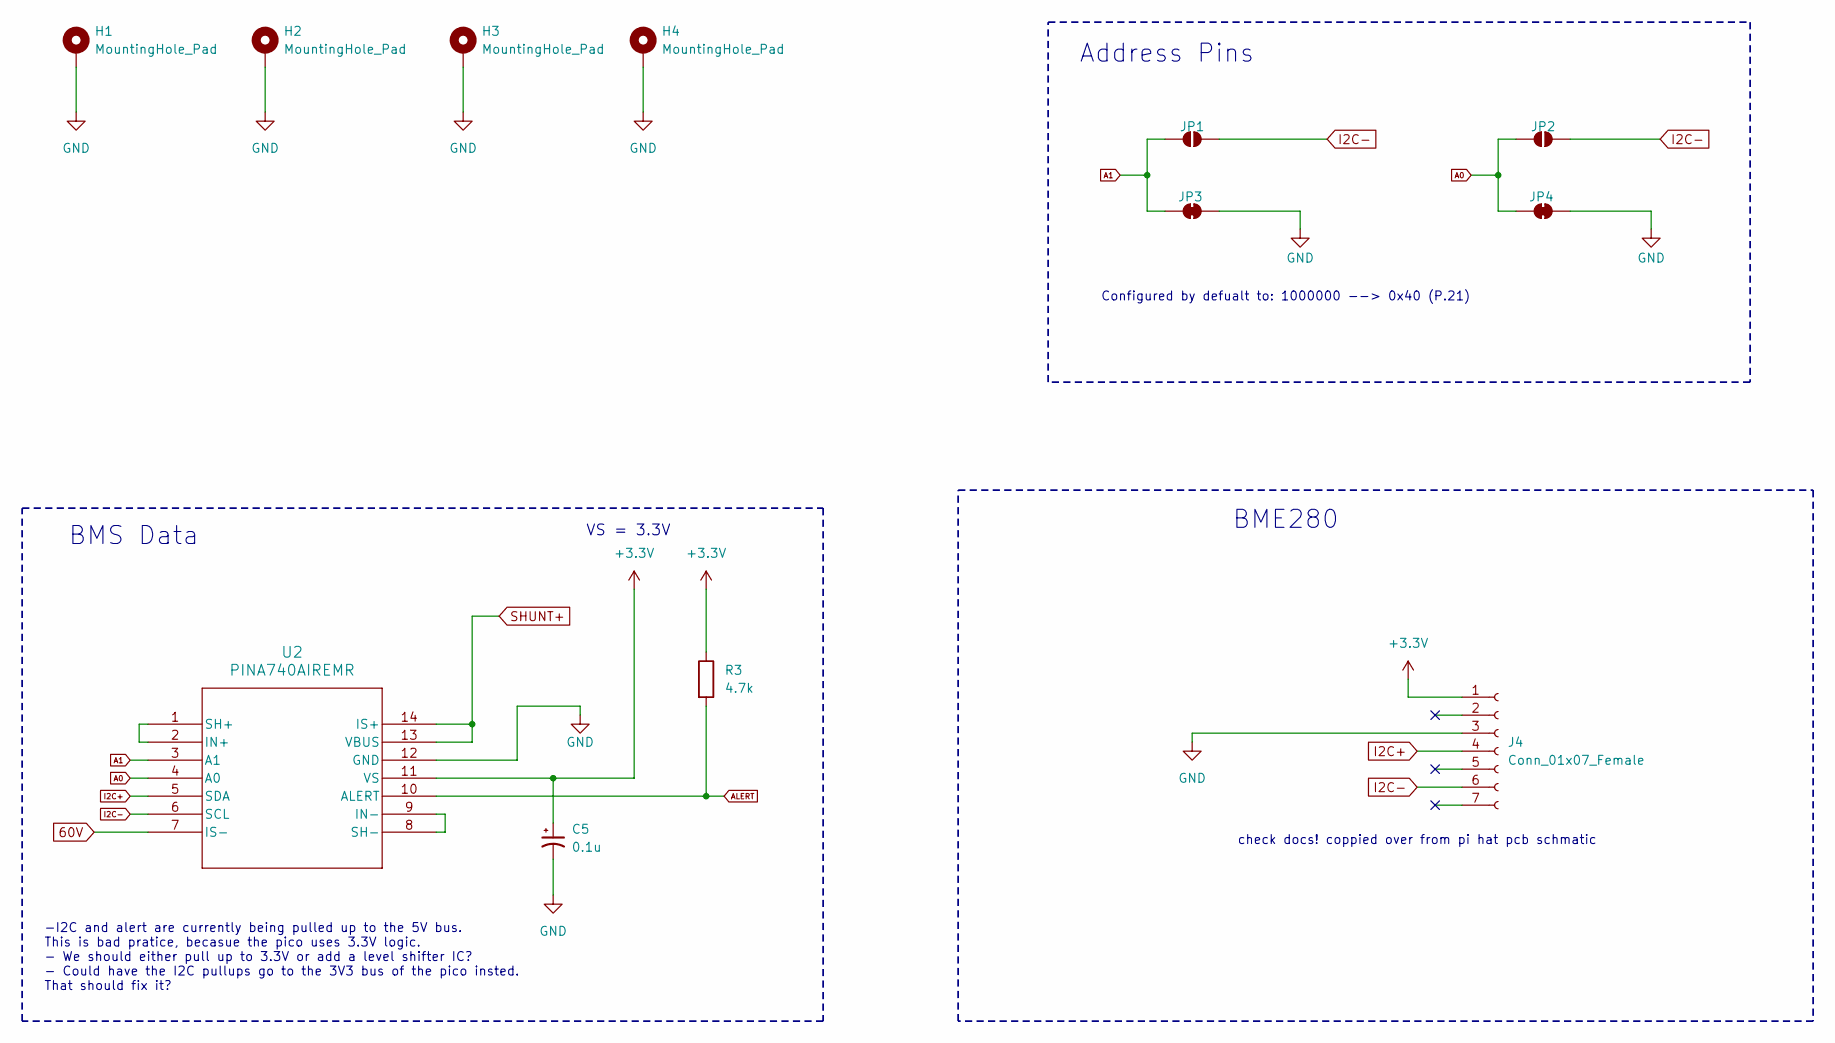
[picture p28: schematic BMS_Data.kicad_sch, I2C Sensors]

Parts:
C5: 0.1u; C_0603_1608Metric_Pad1.08x0.95mm_HandSolder
H1, H2, H3, H4: MountingHole_Pad; MountingHole_4.3mm_M4_Pad_Via
J4: Conn_01x07_Female; PinSocket_1x07_P2.54mm_Vertical
JP1, JP2: SolderJumper_2_Open; SolderJumper-2_P1.3mm_Open_RoundedPad1.0x1.5mm
JP3, JP4: SolderJumper_2_Bridged; SolderJumper-2_P1.3mm_Bridged_RoundedPad1.0x1.5mm
R3: 4.7k; R_0805_2012Metric_Pad1.20x1.40mm_HandSolder
U2: PINA740AIREMR; INA740BIREMR

Connections:
60V: U2.7 (IS-); also elsewhere on the board
+3.3V: C5.1, J4.1, R3.1, U2.11 (VS); also elsewhere on the board
A0: JP2.1 (A), JP4.1 (A), U2.4 (A0)
A1: JP1.1 (A), JP3.1 (A), U2.3 (A1)
ALERT: R3.2, U2.10 (ALERT); also elsewhere on the board
GND: C5.2, H1.1, H2.1, H3.1, H4.1, J4.3, JP3.2 (B), JP4.2 (B), U2.12 (GND); also elsewhere on the board
I2C+: J4.4, U2.5 (SDA); also elsewhere on the board
I2C-: J4.6, JP1.2 (B), JP2.2 (B), U2.6 (SCL); also elsewhere on the board
unnamed: U2.1 (SH+), U2.2 (IN+)
unnamed: U2.8 (SH-), U2.9 (IN-)
SHUNT+: U2.13 (VBUS), U2.14 (IS+); also elsewhere on the board

Notes on the sheet:
BMS Data
BME280
check docs! coppied over from pi hat pcb schmatic
Address Pins
VS = 3.3V
-I2C and alert are currently being pulled up to the 5V bus. This is bad pratice, becasue the pico uses 3.3V logic. - We should either pull up to 3.3V or add a level shifter IC? - Could have the I2C pullups go to the 3V3 bus of the pico insted. That should fix it?
Configured by defualt to: 1000000 --> 0x40 (P.21)
