CabrilloRoboticsClub/robosub_electrical/Backplane_Board/Backplane_Board.kicad_pcb

## KiCad design Backplane_Board/Backplane_Board.kicad_pcb (continued)

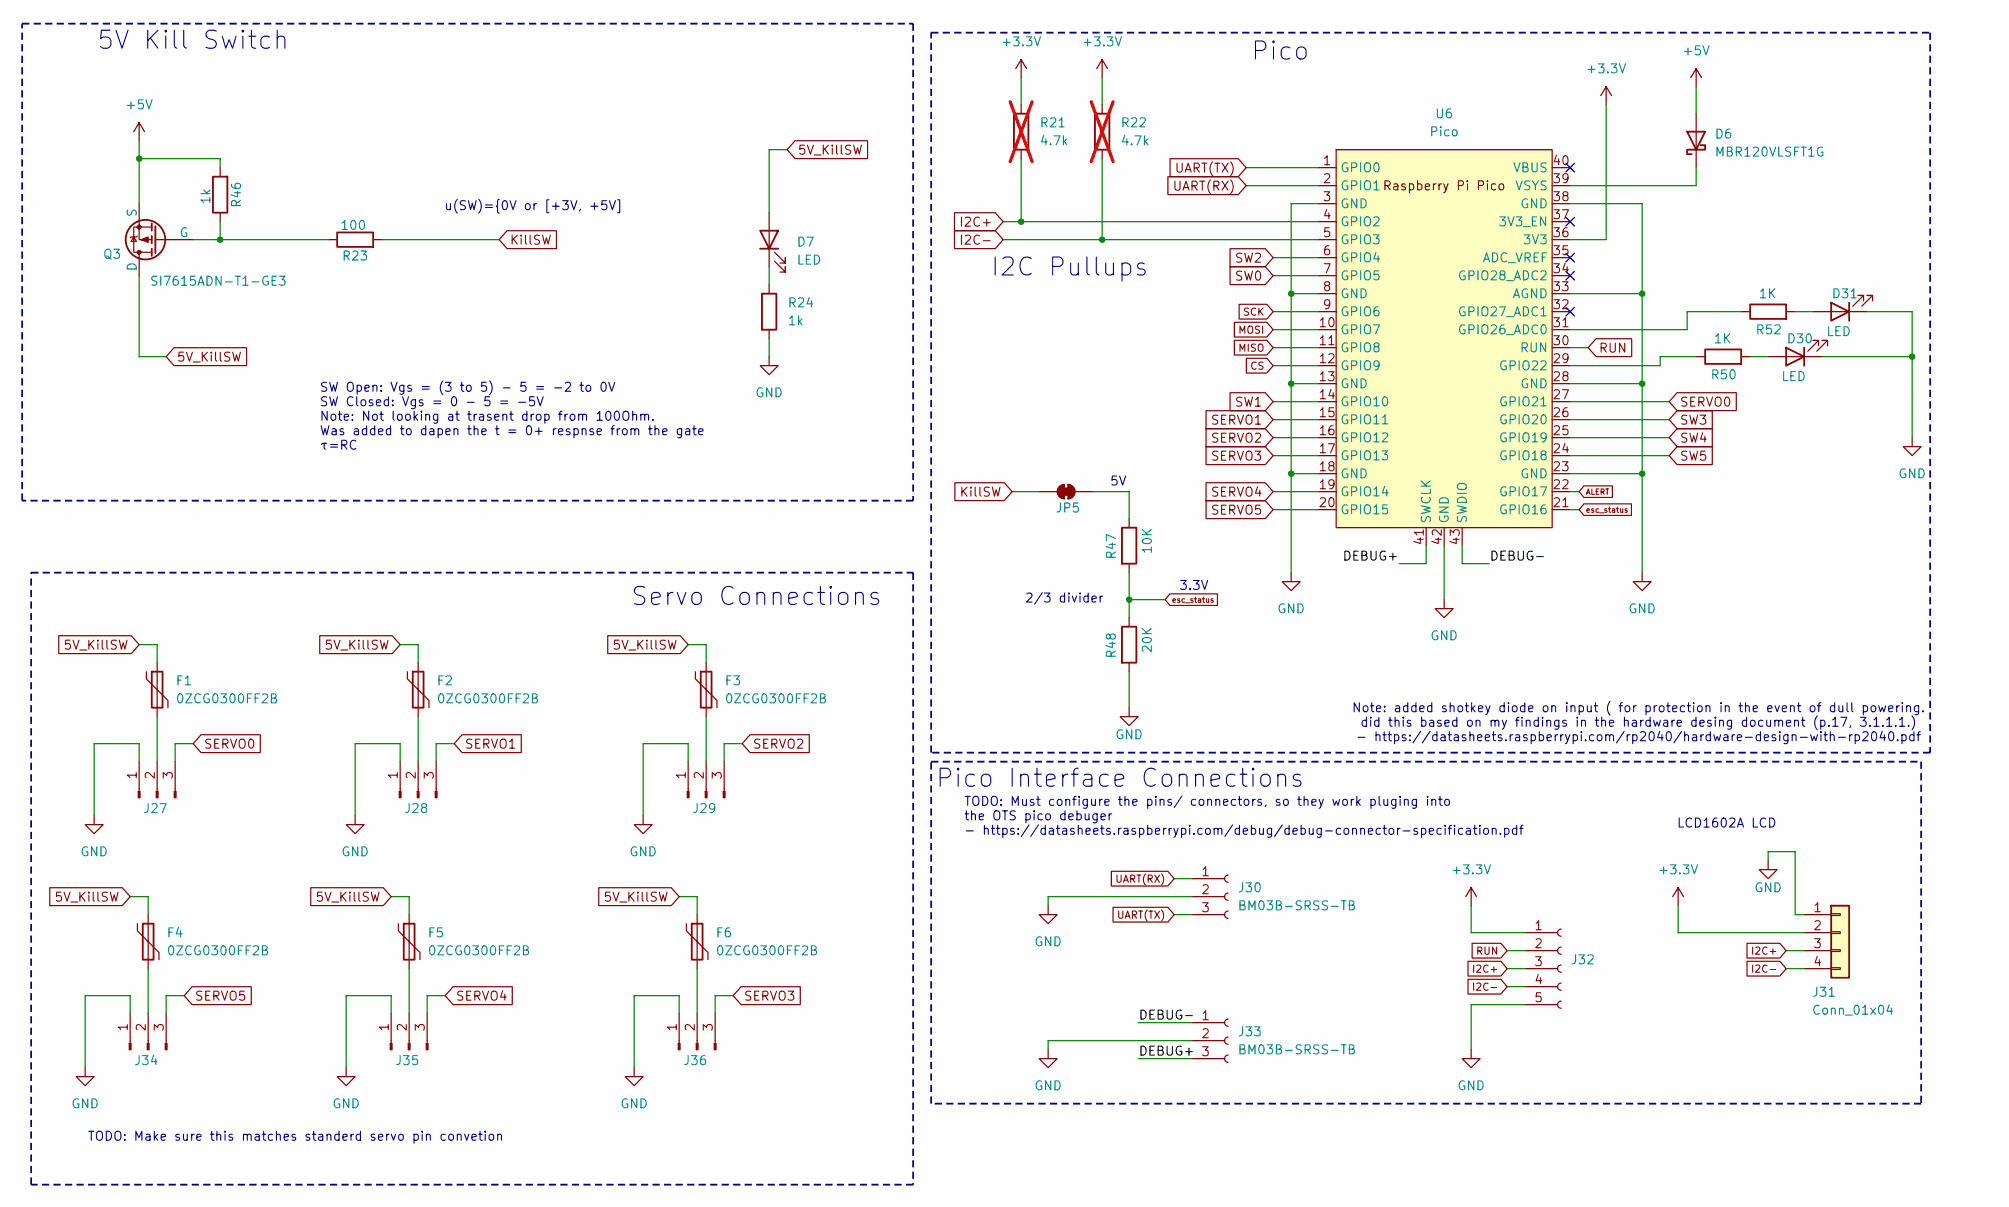
[picture p29: schematic BoardBoardConnections.kicad_sch, Backplane_Board]

Parts:
D6: MBR120VLSFT1G; D_SOD-123F
D7, D30, D31: LED; LED_0603_1608Metric
F1, F2, F3, F4, F5, F6: 0ZCG0300FF2B; Fuse_1812_4532Metric
J27, J28, J29, J36: Conn_01x03_Pin; PinHeader_1x03_P2.54mm_Vertical
J30, J33: BM03B-SRSS-TB; JST_SH_BM03B-SRSS-TB_1x03-1MP_P1.00mm_Vertical
J31: Conn_01x04; Molex_PicoBlade_53047-0410_1x04_P1.25mm_Vertical
J32: Conn_01x05_Socket; PinSocket_1x05_P2.54mm_Vertical
J34, J35: Connector_PinHeader_2.54mm:PinHeader_1x03_P2.54mm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; PinHeader_1x03_P2.54mm_Vertical
JP5: SolderJumper_2_Bridged; SolderJumper-2_P1.3mm_Bridged_RoundedPad1.0x1.5mm
Q3: SI7615ADN-T1-GE3; SON8_SI7615ADN-T1-GE3_VIS-L
R21, R22: 4.7k; R_1206_3216Metric_Pad1.30x1.75mm_HandSolder; not fitted
R23: 100; R_0805_2012Metric_Pad1.20x1.40mm_HandSolder
R24, R46: 1k; R_0805_2012Metric_Pad1.20x1.40mm_HandSolder
R47: 10K; R_0805_2012Metric_Pad1.20x1.40mm_HandSolder
R48: 20K; R_0805_2012Metric_Pad1.20x1.40mm_HandSolder
R50, R52: 1K; R_0805_2012Metric_Pad1.20x1.40mm_HandSolder
U6: Pico; RPi_Pico_SMD_TH

Connections:
5V_KillSW: D7.2 (A), F1.1, F2.1, F3.1, F4.1, F5.1, F6.1, Q3.1 (D); also elsewhere on the board
+3.3V: J31.2, J32.1, R21.1, R22.1, U6.36 (3V3); also elsewhere on the board
+5V: D6.2 (A), Q3.3 (S), R46.2; also elsewhere on the board
/BoardBoardConnections/DEBUG+: J33.3, U6.41 (SWCLK)
/BoardBoardConnections/DEBUG-: J33.1, U6.43 (SWDIO)
ALERT: U6.22 (GPIO17); also elsewhere on the board
CS: U6.12 (GPIO9); also elsewhere on the board
GND: D30.1 (K), D31.1 (K), J27.1, J28.1, J29.1, J30.2, J31.1, J32.5, J33.2, J34.1, J35.1, J36.1, R24.2, R48.2, U6.3 (GND), U6.8 (GND), U6.13 (GND), U6.18 (GND), U6.23 (GND), U6.28 (GND), U6.33 (AGND), U6.38 (GND), U6.42 (GND); also elsewhere on the board
I2C+: J31.3, J32.3, R21.2, U6.4 (GPIO2); also elsewhere on the board
I2C-: J31.4, J32.4, R22.2, U6.5 (GPIO3); also elsewhere on the board
KillSW: JP5.2 (B), R23.2; also elsewhere on the board
MISO: U6.11 (GPIO8); also elsewhere on the board
MOSI: U6.10 (GPIO7); also elsewhere on the board
unnamed: D6.1 (K), U6.39 (VSYS)
unnamed: D7.1 (K), R24.1
unnamed: D30.2 (A), R50.2
unnamed: D31.2 (A), R52.2
unnamed: F1.2, J27.2
unnamed: F2.2, J28.2
unnamed: F3.2, J29.2
unnamed: F4.2, J34.2
unnamed: F5.2, J35.2
unnamed: F6.2, J36.2
unnamed: JP5.1 (A), R47.1
unnamed: Q3.2 (G), R23.1, R46.1
unnamed: R50.1, U6.29 (GPIO22)
unnamed: R52.1, U6.31 (GPIO26_ADC0)
RUN: J32.2, U6.30 (RUN)
SCK: U6.9 (GPIO6); also elsewhere on the board
SERVO0: J27.3, U6.27 (GPIO21)
SERVO1: J28.3, U6.15 (GPIO11)
SERVO2: J29.3, U6.16 (GPIO12)
SERVO3: J36.3, U6.17 (GPIO13)
SERVO4: J35.3, U6.19 (GPIO14)
SERVO5: J34.3, U6.20 (GPIO15)
SW0: U6.7 (GPIO5); also elsewhere on the board
SW1: U6.14 (GPIO10); also elsewhere on the board
SW2: U6.6 (GPIO4); also elsewhere on the board
SW3: U6.26 (GPIO20); also elsewhere on the board
SW4: U6.25 (GPIO19); also elsewhere on the board
SW5: U6.24 (GPIO18); also elsewhere on the board
UART(RX): J30.1, U6.2 (GPIO1); also elsewhere on the board
UART(TX): J30.3, U6.1 (GPIO0); also elsewhere on the board
esc_status: R47.2, R48.1, U6.21 (GPIO16)

Notes on the sheet:
Pico Interface Connections
u(SW)={0V or [+3V, +5V]
Pico
SW Open: Vgs = (3 to 5) - 5 = -2 to 0V SW Closed: Vgs = 0 - 5 = -5V Note: Not looking at trasent drop from 100Ohm. Was added to dapen the t = 0+ respnse from the gate τ=RC
Note: added shotkey diode on input ( for protection in the event of dull powering. did this based on my findings in the hardware desing document (p.17, 3.1.1.1.) - https://datasheets.raspberrypi.com/rp2040/hardware-design-with-rp2040.pdf
Servo Connections
LCD1602A LCD
5V Kill Switch
TODO: Make sure this matches standerd servo pin convetion
2/3 divider
TODO: Must configure the pins/ connectors, so they work pluging into the OTS pico debuger - https://datasheets.raspberrypi.com/debug/debug-connector-specification.pdf
I2C Pullups
3.3V

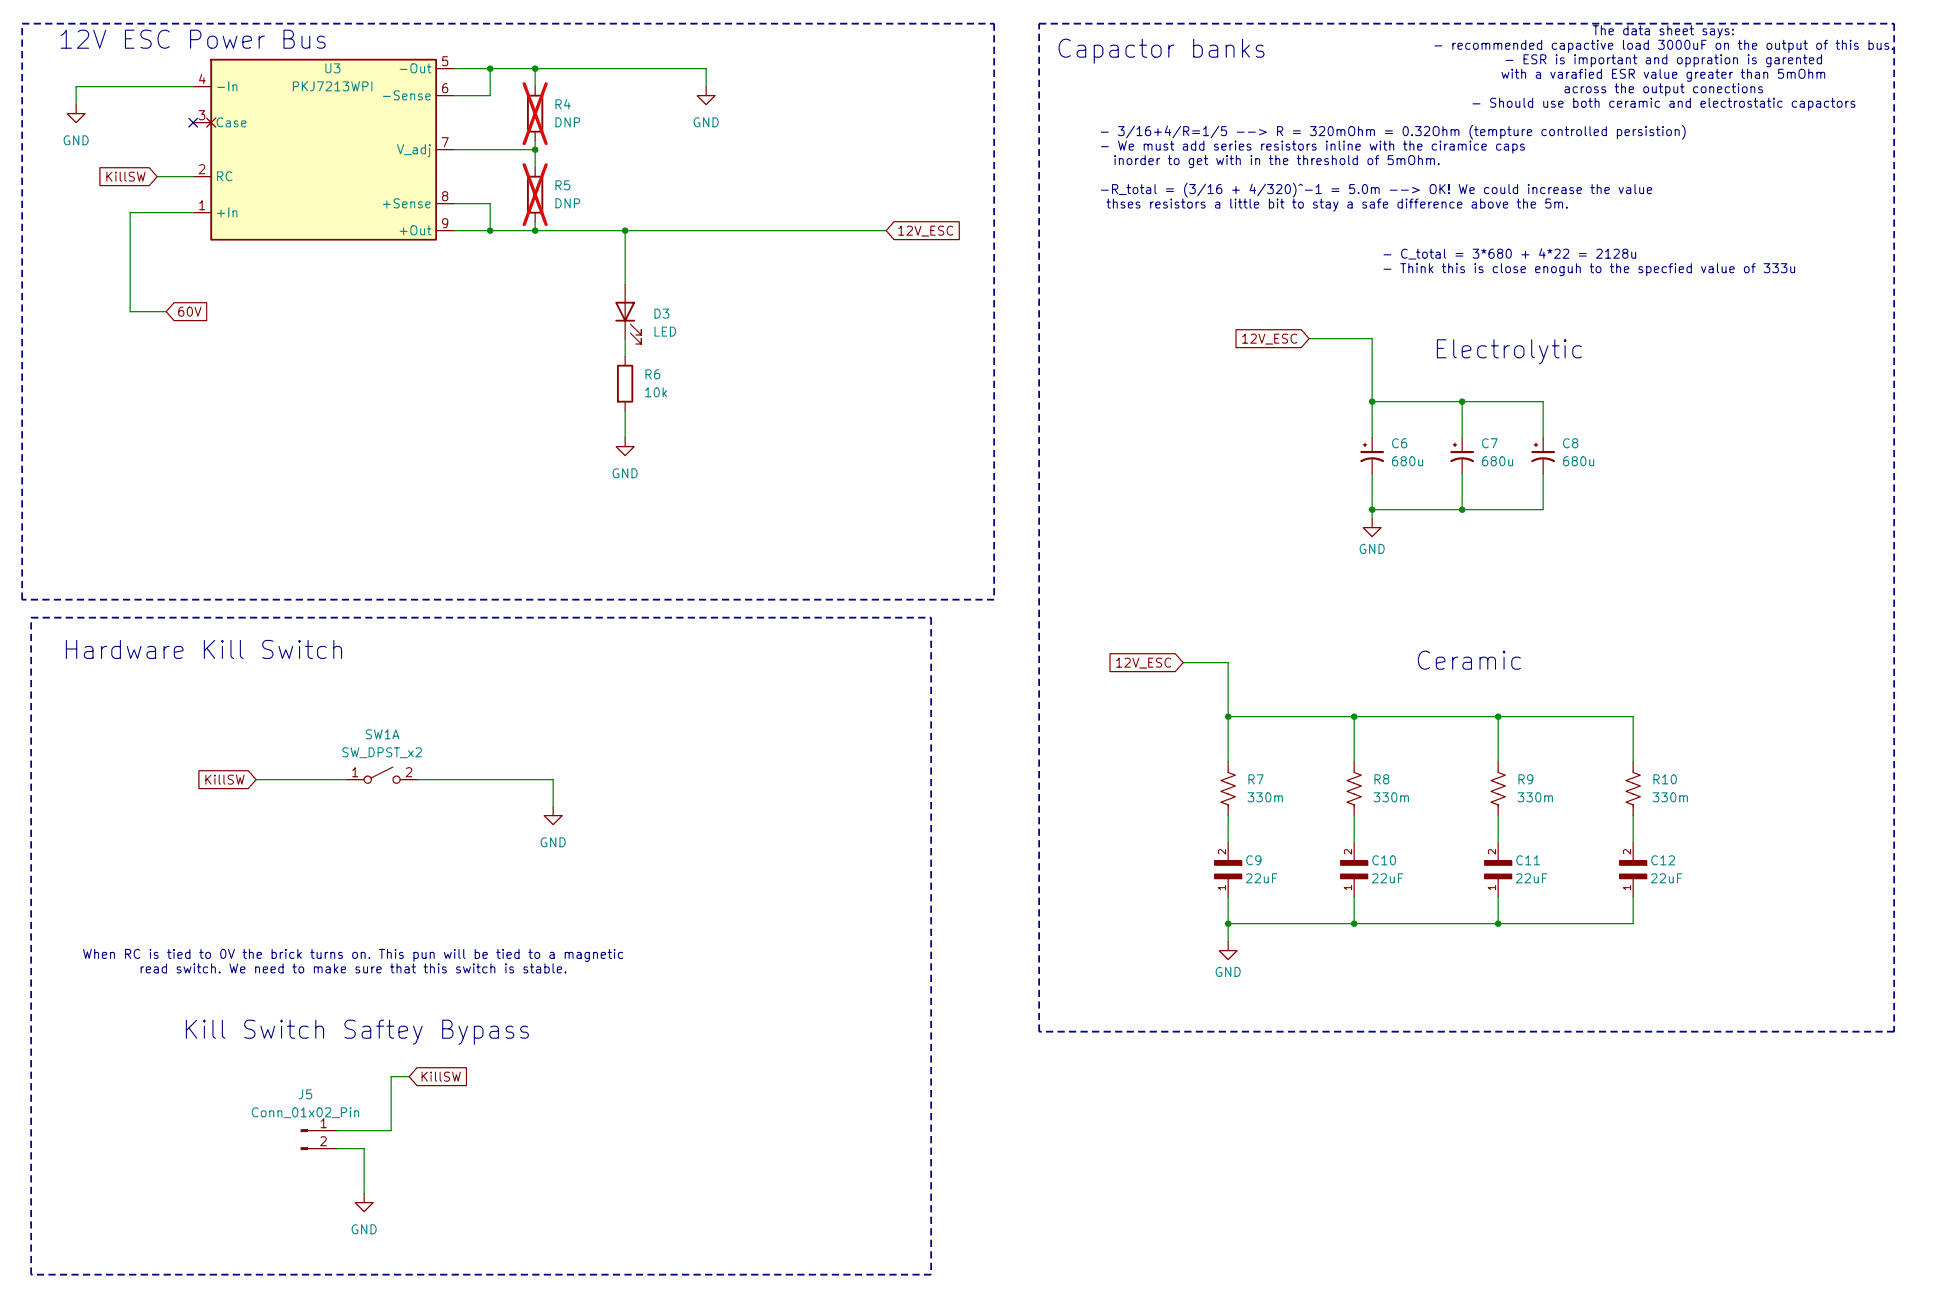
[picture p30: schematic ESC_Power_Bus.kicad_sch, ESC Power Bus]

Parts:
C6, C7, C8: 680u; CP_Radial_D13.0mm_P5.00mm
C9, C10, C11, C12: 22uF; C_1206_3216Metric_Pad1.33x1.80mm_HandSolder
D3: LED; LED_0603_1608Metric
J5: Conn_01x02_Pin; PinHeader_1x02_P2.54mm_Vertical
R4, R5: DNP; L_1206_3216Metric; not fitted
R6: 10k; R_0805_2012Metric_Pad1.20x1.40mm_HandSolder
R7, R8, R9, R10: 330m; RES_KDV12_OHM-L
SW1: SW_DPST_x2; TerminalBlock_Xinya_XY308-2.54-2P_1x02_P2.54mm_Horizontal
U3: PKJ7213WPI

Connections:
12V_ESC: C6.1, C7.1, C8.1, D3.2 (A), R5.2, R7.1, R8.1, R9.1, R10.1, U3.8 (+Sense), U3.9 (+Out); also elsewhere on the board
60V: U3.1 (+In); also elsewhere on the board
GND: C6.2, C7.2, C8.2, C9.1, C10.1, C11.1, C12.1, J5.2, R4.1, R6.2, SW1.2 (B), U3.4 (-In), U3.5 (-Out), U3.6 (-Sense); also elsewhere on the board
KillSW: J5.1, SW1.1 (A), U3.2 (RC); also elsewhere on the board
unnamed: C9.2, R7.2
unnamed: C10.2, R8.2
unnamed: C11.2, R9.2
unnamed: C12.2, R10.2
unnamed: D3.1 (K), R6.1
unnamed: R4.2, R5.1, U3.7 (V_adj)

Notes on the sheet:
- 3/16+4/R=1/5 --> R = 320mOhm = 0.32Ohm (tempture controlled persistion) - We must add series resistors inline with the ciramice caps inorder to get with in the threshold of 5mOhm. -R_total = (3/16 + 4/320)^-1 = 5.0m --> OK! We could increase the value thses resistors a little bit to stay a safe d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
12V ESC Power Bus
The data sheet says: - recommended capactive load 3000uF on the output of this bus. - ESR is important and oppration is garented with a varafied ESR value greater than 5mOhm across the output conections - Should use both ceramic and electrostatic capactors
Ceramic
Electrolytic
Hardware Kill Switch
- C_total = 3*680 + 4*22 = 2128u - Think this is close enoguh to the specfied value of 333u
Kill Switch Saftey Bypass
Capactor banks
When RC is tied to 0V the brick turns on. This pun will be tied to a magnetic read switch. We need to make sure that this switch is stable.

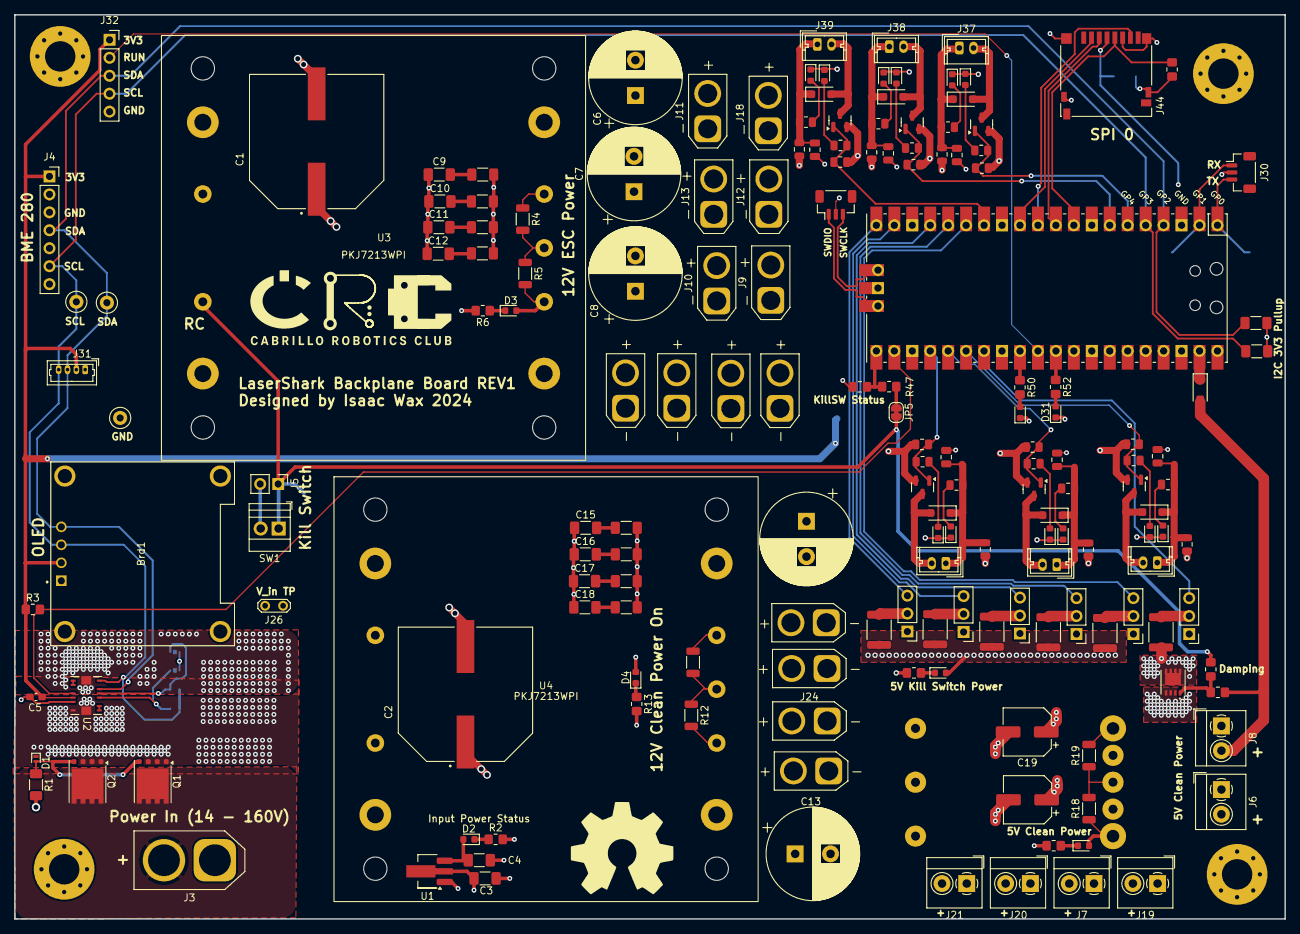
[picture p31: board Backplane_Board.kicad_pcb from above]

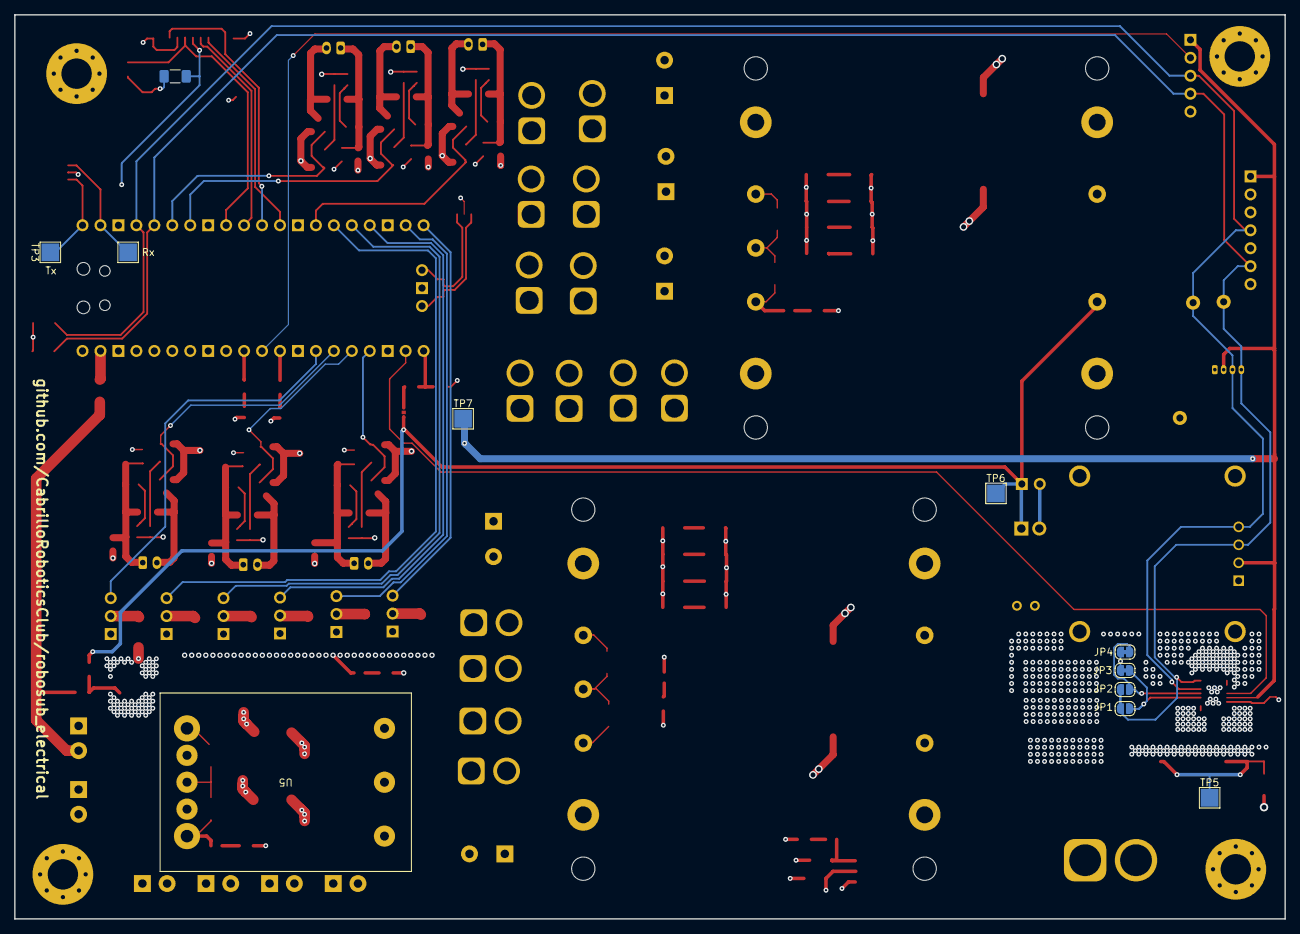
[picture p32: board Backplane_Board.kicad_pcb from below]

Board: 4 copper layers, 179.7 x 127.9 mm, 189 parts (11 on the bottom side), 94 nets.
