CabrilloRoboticsClub/robosub_electrical/(commit log)

2024-08-15 add sesecond sid
    [TopLevelSID.kicad_pcb, TopLevelSID.kicad_sch]
2024-08-18 rp2040 libary test
    [ESC_Board.kicad_pcb, ESC_Board.kicad_sch, RP2040.kicad_sch]
2024-08-19 added basic rp2040 componets
    [ESC_Board.kicad_sch, RP2040.kicad_sch]
2024-08-19 added esc interface pageand added test points to the rp2040 page
    [ESC_Board.kicad_sch, RP2040.kicad_sch]
2024-08-21 schematic done, ready for review. need to think about how this will connect to the backplane
    [ESC_Board.kicad_sch, RP2040.kicad_sch]
2024-08-23 add hardware board
    [AD Converters.kicad_sch, Hardware_Board.kicad_pcb, Hardware_Board.kicad_sch, RASPBERRY PI.kicad_sch, Switching.kicad_sch]
2024-09-06 esc board updated
    [AD Converters.kicad_sch, ESC_Board.kicad_sch, Hardware_Board.kicad_sch, IPS1-120-01-L-D.step, IPS1-120-01-L-D.stp, RASPBERRY PI.kicad_sch, RP2040.kicad_sch, Switching.kicad_sch]
2024-09-25 added more updates
    [Backplane_Board.kicad_pcb, Backplane_Board.kicad_sch, RP2040.kicad_sch]
2024-09-27 added power brick symbles and added power buses to backplane board
    [12V_Power_Bus.kicad_sch, Backplane_Board.kicad_sch, ESC_Power_Bus.kicad_sch, PKU3500S_FPM.step, Power_Connectors.kicad_sch]
2024-09-30 added ad converter
    [12V_Power_Bus.kicad_sch, Backplane_Board.kicad_sch, ESC_Power_Bus.kicad_sch, Voltage Level ADC.kicad_sch]
2024-10-02 add rerevised esc board and rough backplane schmatic
    [12V_Power_Bus.kicad_sch, Backplane_Board.kicad_sch, BoardBoardConnections.kicad_sch, ESC_Board_RP2040.kicad_pcb, ESC_Board_RP2040.kicad_sch, ESC_Power_Bus.kicad_sch, FPM-3DSTEP-PKJ7200W-simplified-typ.stp, Power_Connectors.kicad_sch]
2024-10-15 backup before heavy revtion
    [12V_Power_Bus.kicad_sch, Backplane_Board.kicad_sch, C2012X5R1V226M125AC.step, ESC_Board_RP2040.kicad_pcb, ESC_Board_RP2040.kicad_sch, ESC_Power_Bus.kicad_sch, RP2040.kicad_sch]
2024-10-21 back plane board ready for review
    [12V_Power_Bus.kicad_sch, Backplane_Board.kicad_sch, ESC_Power_Bus.kicad_sch, Power_Connectors.kicad_sch]
2024-10-25 adding dull power path ic into sepret exption board
    [12V_Power_Bus.kicad_sch, ESC_Power_Bus.kicad_sch]
2024-10-26 updated input revers polarity protection
    [BMS_Data.kicad_sch, Backplane_Board.kicad_sch]
2024-10-26 reviewed and cleaned up management ic
    [BMS_Data.kicad_sch, Backplane_Board.kicad_sch]
2024-10-28 more updates
    [BMS_Data.kicad_sch]
2024-10-29 added series resistors on the ceramic caps to get the esr in range
    [RES_KDV12_OHM.step]
2024-10-29 brick footprint
2024-10-29 from desing review 1
    [12V_Power_Bus.kicad_sch, ESC_Power_Bus.kicad_sch]
2024-11-01 added pico and 5v killSW
    [12V_Power_Bus.kicad_sch, BMS_Data.kicad_sch, Backplane_Board.kicad_sch, BoardBoardConnections.kicad_sch, ESC_Power_Bus.kicad_sch, Power_Connectors.kicad_sch]
2024-11-01 added more pico stuff
    [BoardBoardConnections.kicad_sch, Power_Connectors.kicad_sch]
2024-11-03 added power swtching circits
    [12V_Power_Bus.kicad_sch, Backplane_Board.kicad_sch, BoardBoardConnections.kicad_sch, Switching.kicad_sch]
2024-11-05 ready for final schmatic review
    [12V_Power_Bus.kicad_sch, BMS_Data.kicad_sch, Backplane_Board.kicad_sch, BoardBoardConnections.kicad_sch, EEVTG2A331M.step, INA740BIREMR.step, Power_Connectors.kicad_sch, REM0014B.stp]
2024-11-15 updated i2c pullups to 3V3 logic, not isolator needed
    [12V_Power_Bus.kicad_sch, BMS_Data.kicad_sch, BoardBoardConnections.kicad_sch, ESC_Power_Bus.kicad_sch, Power_Connectors.kicad_sch, SI7615ADN-T1-GE3.STEP, Switching.kicad_sch]
2024-11-19 update FET circits
    [0ZCG_BEL.step, 12V_Power_Bus.kicad_sch, BMS_Data.kicad_sch, Backplane_Board.kicad_sch, BoardBoardConnections.kicad_sch, ESC_Power_Bus.kicad_sch, Power_Connectors.kicad_sch, Switching.kicad_sch]
2024-11-20 adding more footprints
    [12V_Power_Bus.kicad_sch, BMS_Data.kicad_sch, Backplane_Board.kicad_pcb, Backplane_Board.kicad_sch, BoardBoardConnections.kicad_sch, ESC_Power_Bus.kicad_sch, Power_Connectors.kicad_sch, Switching.kicad_sch]
2024-11-23 derat nest ifcation
    [12V_Power_Bus.kicad_sch, BMS_Data.kicad_sch, Backplane_Board.kicad_pcb, Backplane_Board.kicad_sch, BoardBoardConnections.kicad_sch, ESC_Power_Bus.kicad_sch, Power_Connectors.kicad_sch, Switching.kicad_sch]
2024-12-17 got the power input shut layout done ish
    [12V_Power_Bus.kicad_sch, Backplane_Board.kicad_pcb, Backplane_Board.kicad_sch, Switching.kicad_sch]
2024-12-17 layout save
    [12V_Power_Bus.kicad_sch, Backplane_Board.kicad_pcb]
2024-12-18 rough layout compleat, 200+ drc errors to fix
    [BMS_Data.kicad_sch, Backplane_Board.kicad_pcb, BoardBoardConnections.kicad_sch, Switching.kicad_sch]
2024-12-18 few drc errors left - must fix fet footprints
    [BMS_Data.kicad_sch, Backplane_Board.kicad_pcb]
2024-12-21 added sd card, more drc stuff to fix
    [Backplane_Board.kicad_pcb, Backplane_Board.kicad_sch, BoardBoardConnections.kicad_sch, DM-OLED096-636.step, Debug.kicad_sch]
2024-12-22 clean up
    [BMS_Data.kicad_sch, Backplane_Board.kicad_pcb, Backplane_Board.kicad_sch, Debug.kicad_sch]
2024-12-23 killed more drc errors
    [Backplane_Board.kicad_pcb]
2024-12-24 add 3d modules and clean up footprints
    [Backplane_Board.kicad_pcb, Debug.kicad_sch, OSTTE020104.step, Power_Connectors.kicad_sch, XT30U-F_IW.STEP]
2025-01-21 add anotations
    [Backplane_Board.kicad_pcb, Backplane_Board.kicad_sch, BoardBoardConnections.kicad_sch, Debug.kicad_sch]
2025-02-01 added gerber
    [12V_Power_Bus.kicad_sch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]
2025-02-02 added html bom
