CabrilloRoboticsClub/robosub_electrical/(notices)

Notices in the files:
libary/IPS1-120-01-L-D/IPS1-120-01-L-D.stp:
author */ ('License CC BY-ND 4.0'),
